spsspssps/spscnc/hw/spscnc/documentation/spscnc_schematic_1.1.0.pdf

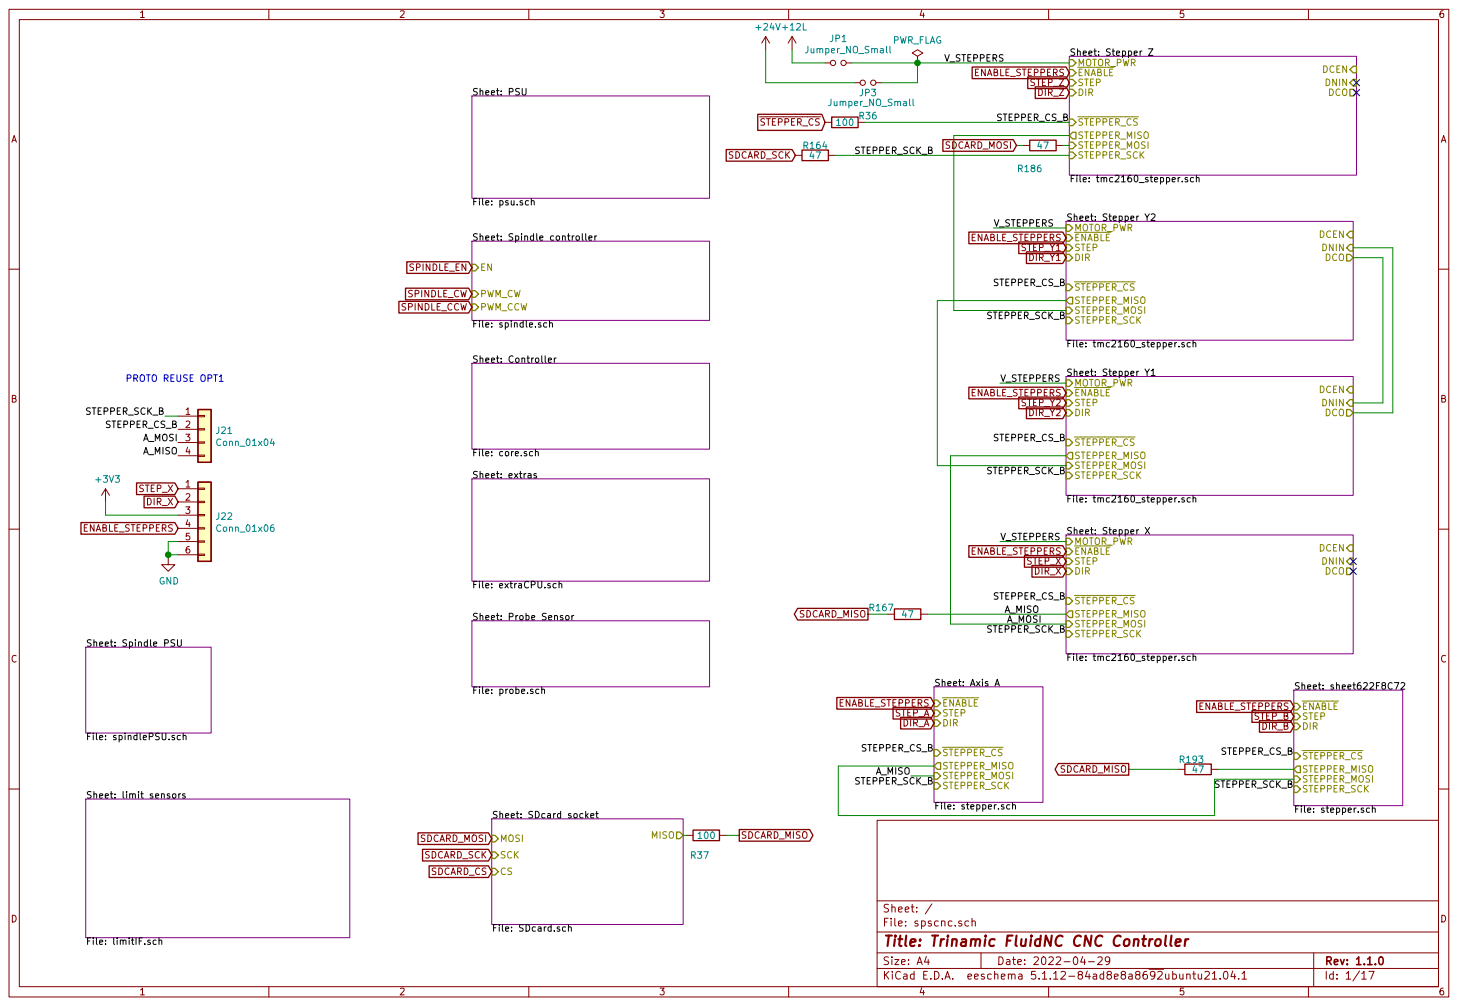
[picture p5: page 1]

Sheet: Probe Sensor File: probe.sch Sheet: extras File: extraCPU.sch Sheet: Spindle controller

File: spindle.sch EN

Sheet: sheet622F8C72 File: stepper.sch STEPPER_CS
ENABLE
STEP DIR

File: spscnc.sch Sheet: /
Id: 1/17 Title: Trinamic FluidNC CNC Controller

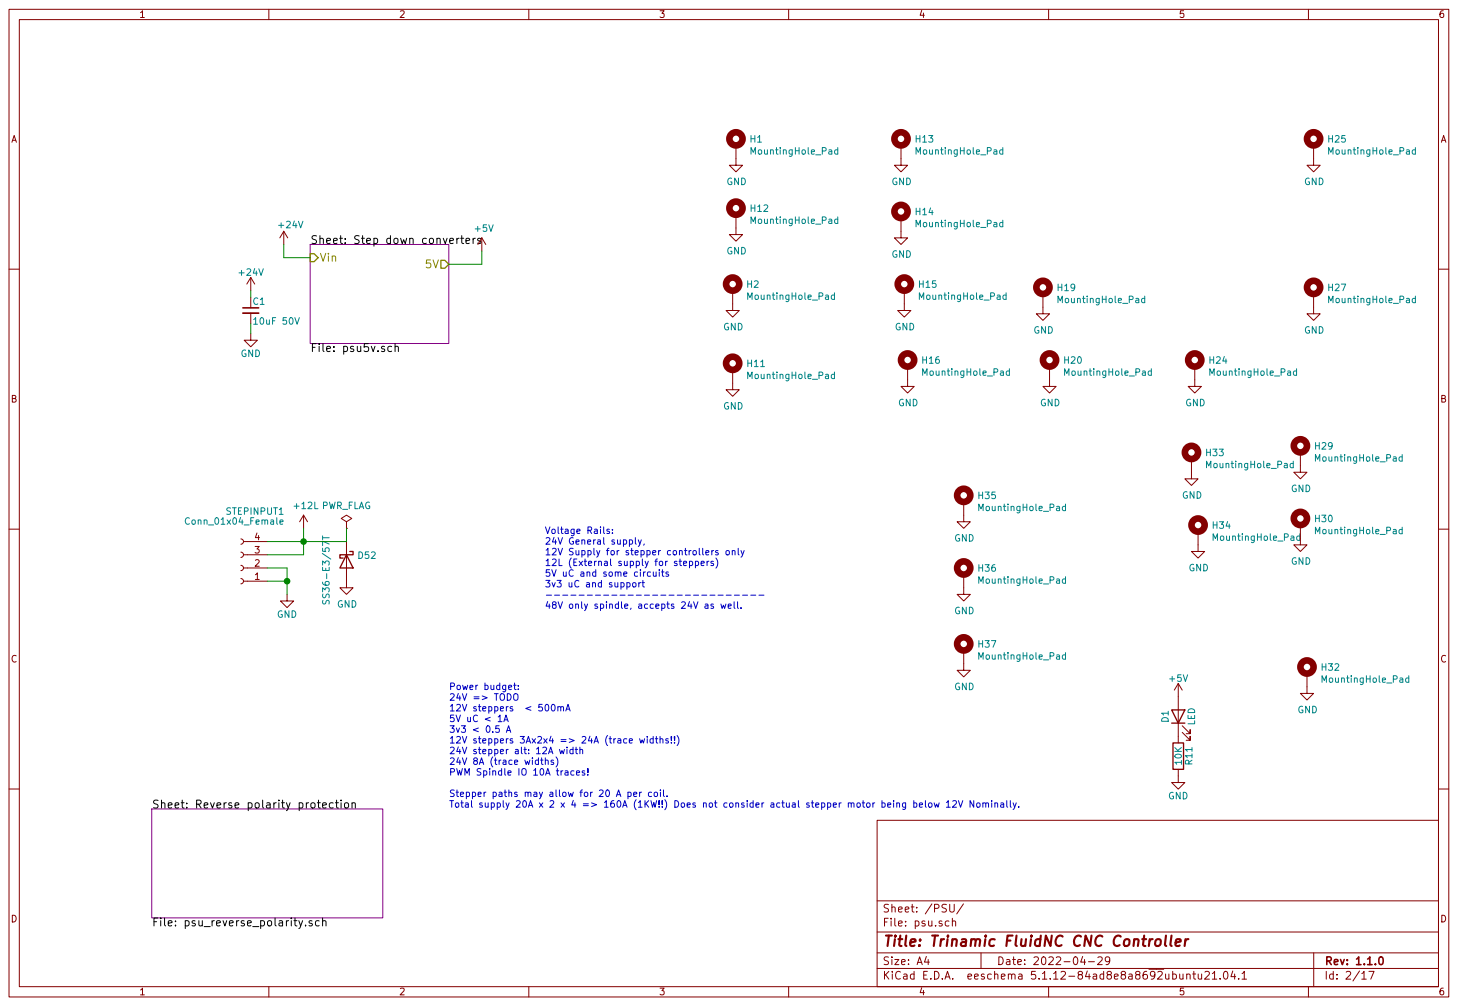
[picture p6: page 2]

Sheet: Step down converters

Voltage Rails:
24V General supply,
12V Supply for stepper controllers only
12L (External supply for steppers) 5V uC and some circuits 3v3 uC and support --------------------------- 48V only spindle, accepts 24V as well.

12V steppers < 500mA
12V steppers 3Ax2x4 => 24A (trace widths!!)
24V stepper alt: 12A width
24V 8A (trace widths)
PWM Spindle IO 10A traces!

Sheet: Reverse polarity protection

Stepper paths may allow for 20 A per coil.
Total supply 20A x 2 x 4 => 160A (1KW!!) Does not consider actual stepper motor being below 12V Nominally.

File: psu.sch Sheet: /PSU/
Id: 2/17 Title: Trinamic FluidNC CNC Controller

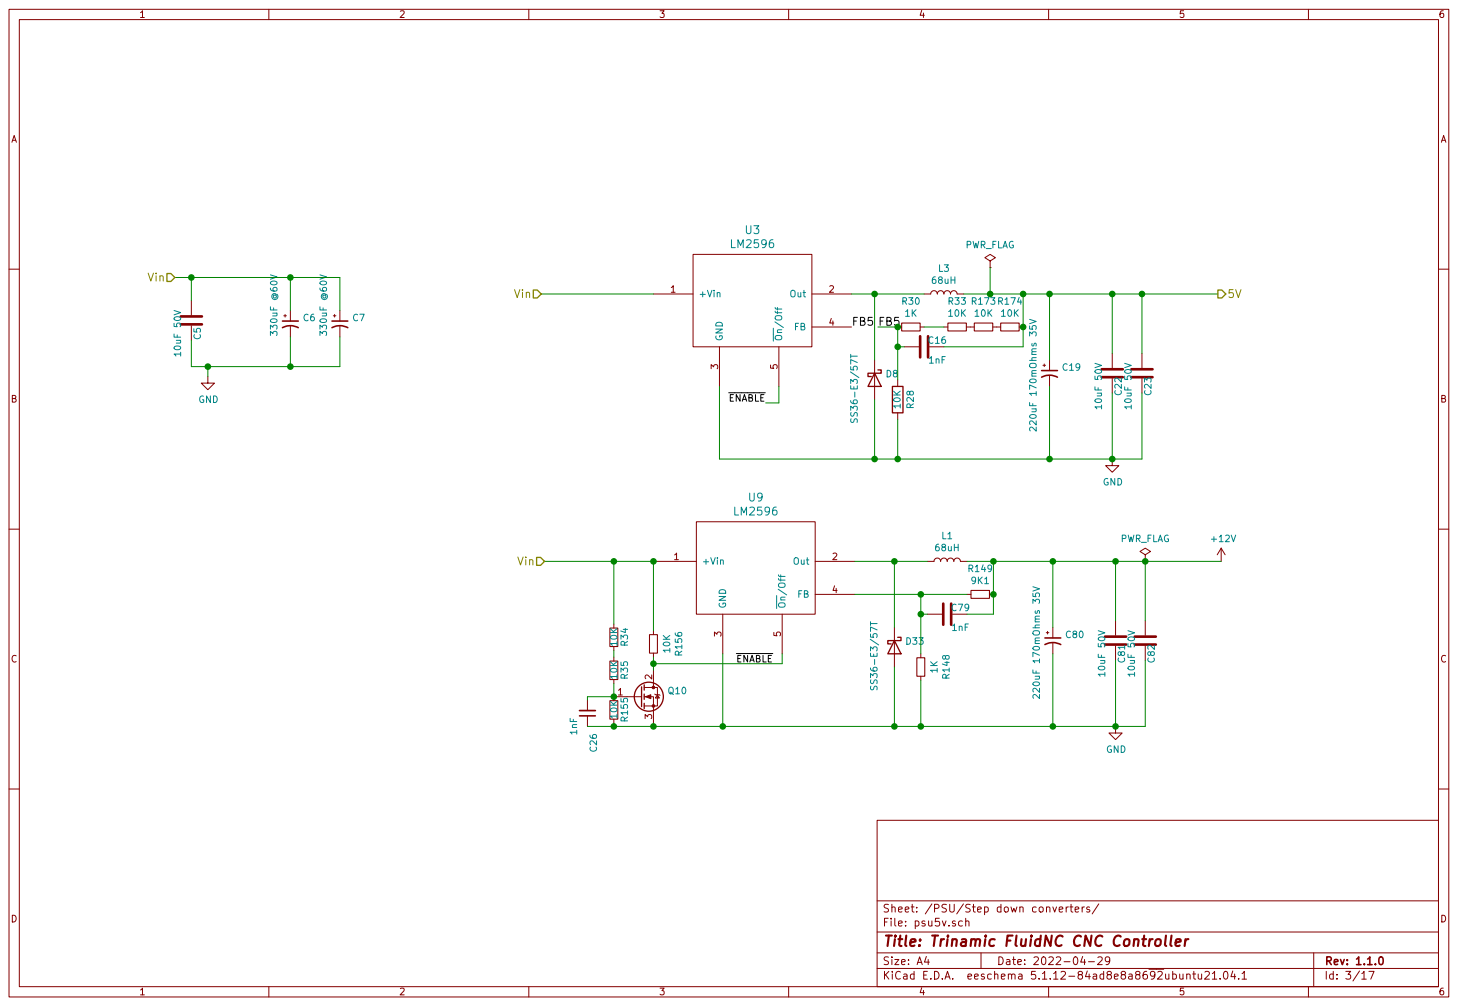
[picture p7: page 3]

File: psu5v.sch
Id: 3/17 Title: Trinamic FluidNC CNC Controller

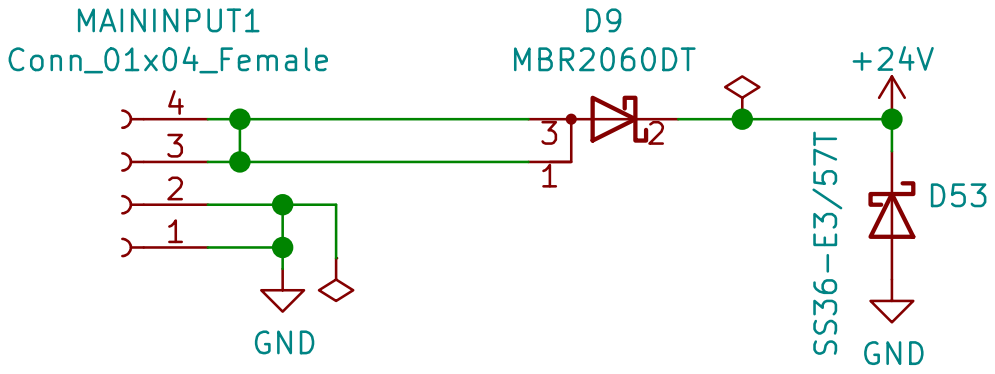
[picture p8: page 4]

File: psu_reverse_polarity.sch
Id: 4/17 Title: Trinamic FluidNC CNC Controller

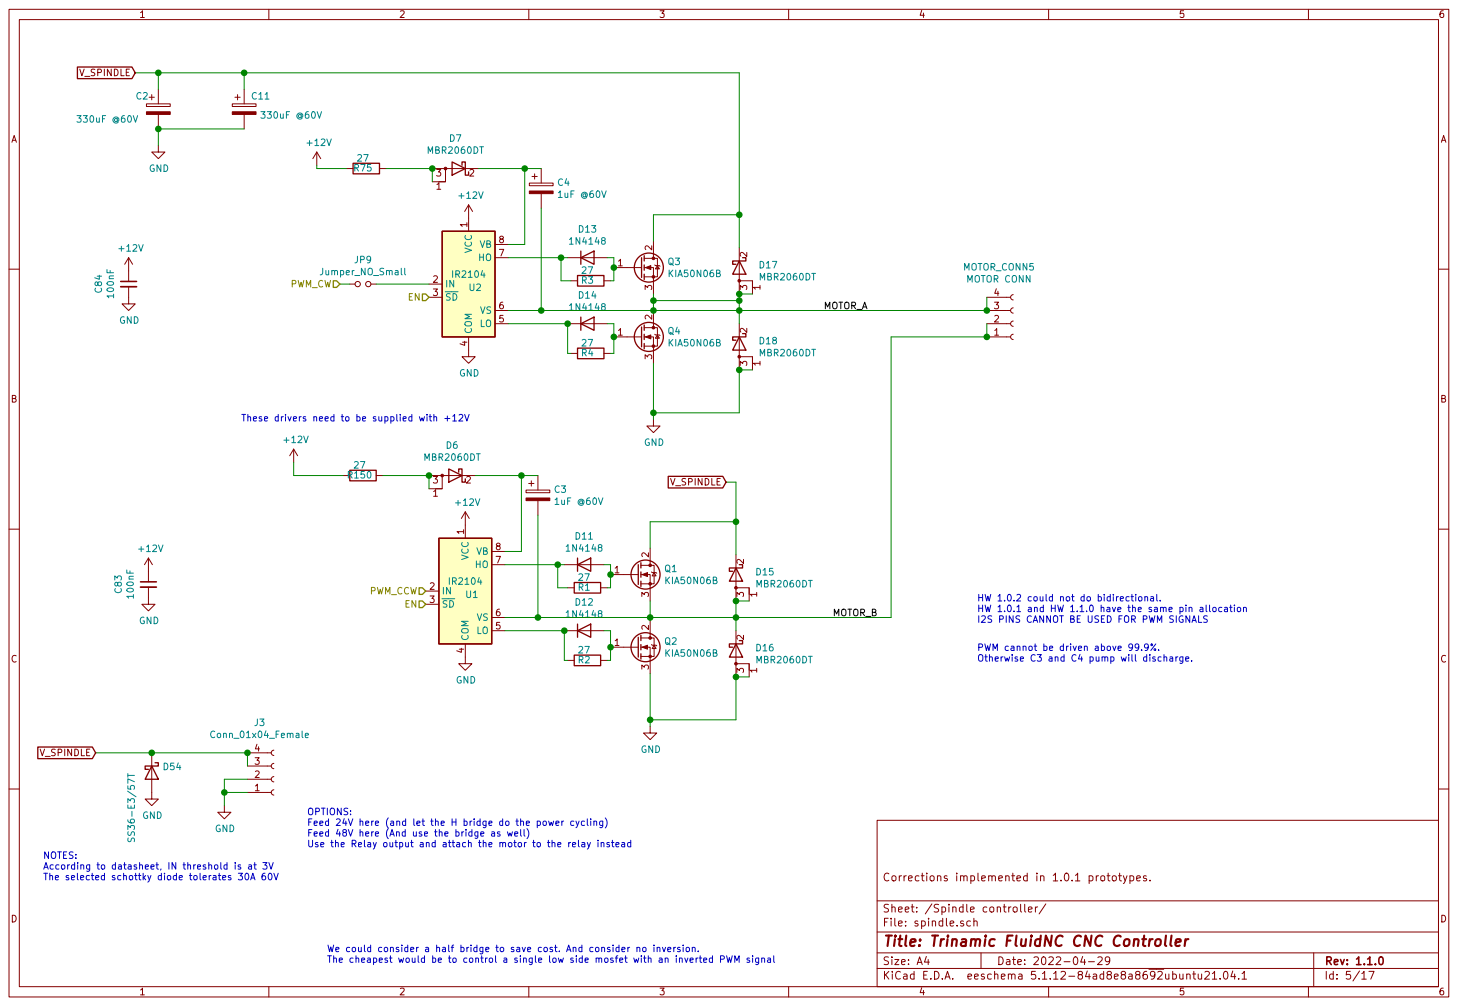
[picture p9: page 5]

These drivers need to be supplied with +12V OPTIONS: Feed 24V here (and let the H bridge do the power cycling)

Corrections implemented in 1.0.1 prototypes. 1

PWM cannot be driven above 99.9%. Otherwise C3 and C4 pump will discharge. HW 1.0.2 could not do bidirectional. HW 1.0.1 and HW 1.1.0 have the same pin allocation

I2S PINS CANNOT BE USED FOR PWM SIGNALS NOTES: According to datasheet, IN threshold is at 3V

Feed 48V here (And use the bridge as well)
Use the Relay output and attach the motor to the relay instead

The selected schottky diode tolerates 30A 60V

Sheet: /Spindle controller/
File: spindle.sch
Id: 5/17 Title: Trinamic FluidNC CNC Controller

We could consider a half bridge to save cost. And consider no inversion.
The cheapest would be to control a single low side mosfet with an inverted PWM signal

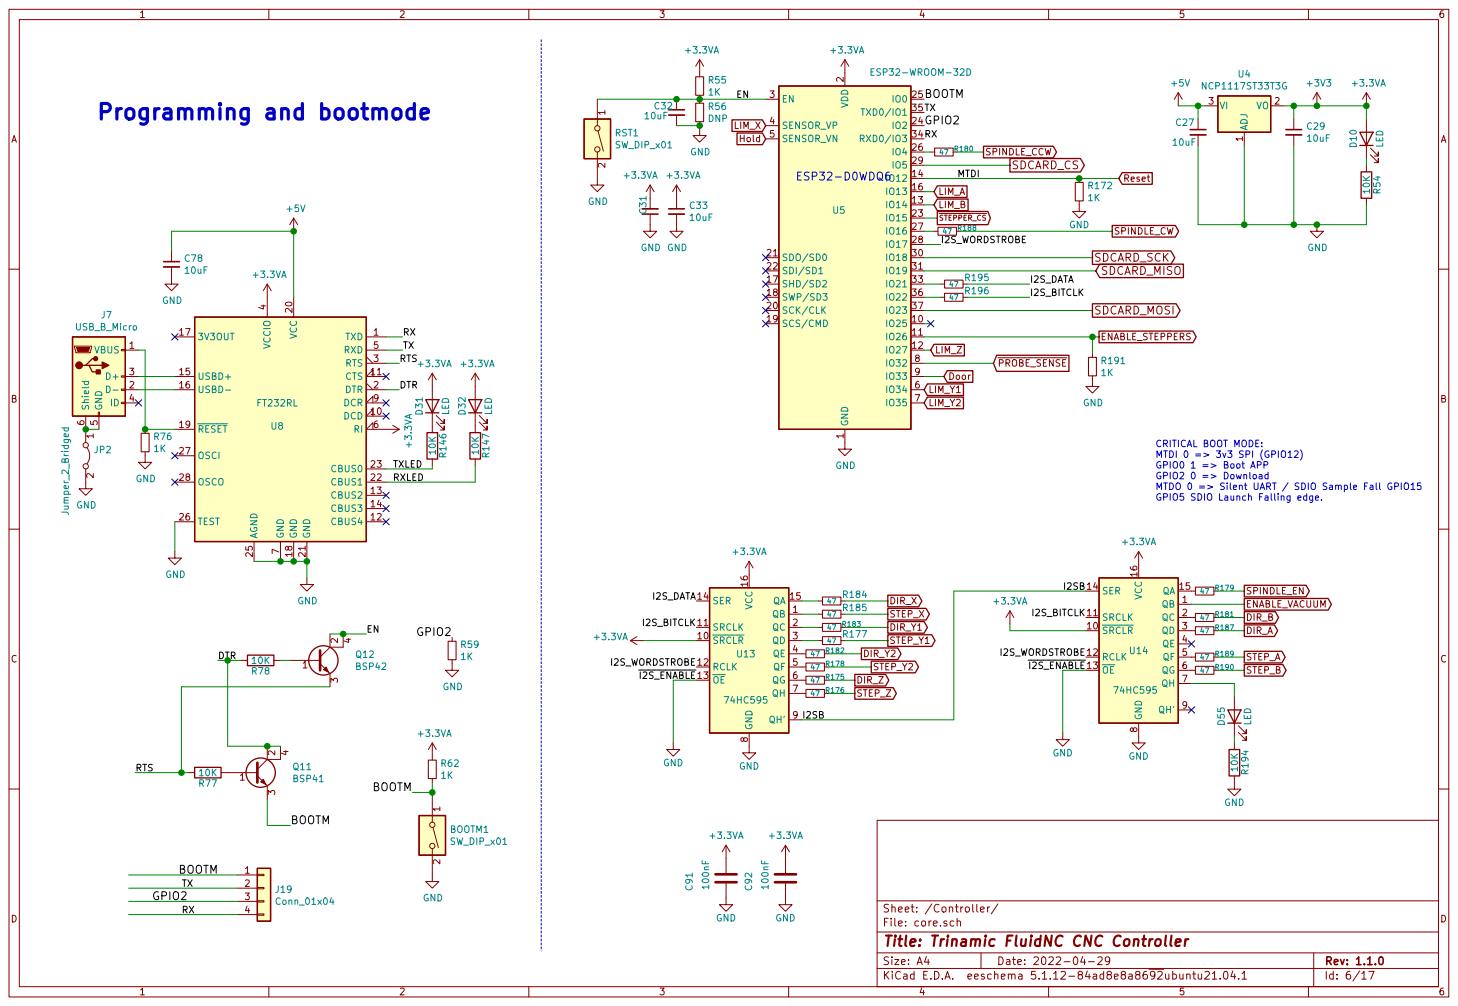
[picture p10: page 6]

2 SCK/CLK 20 SDO/SD0 21 SDI/SD1 22

GPIO5 SDIO Launch Falling edge.

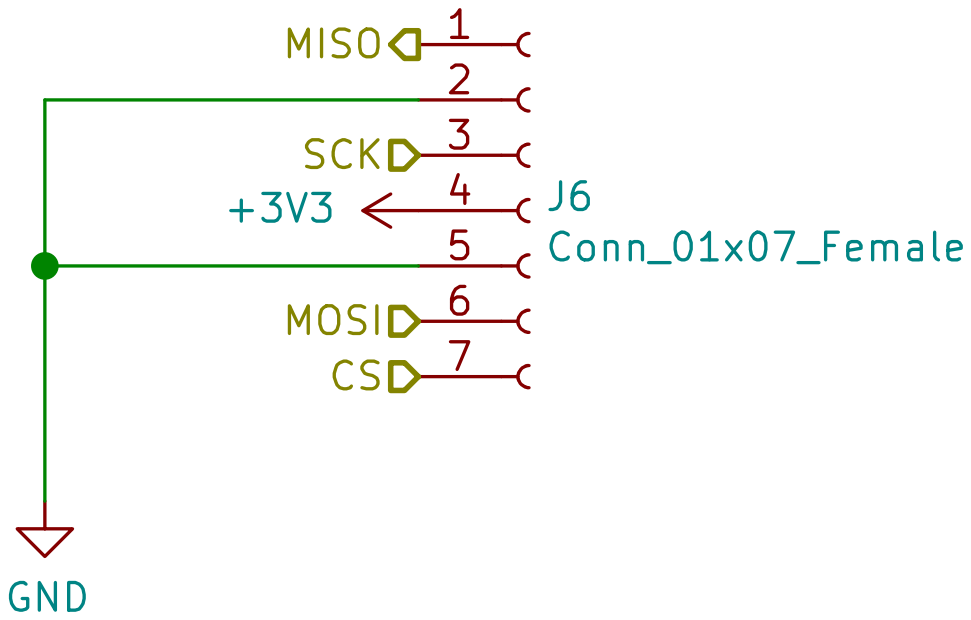
[picture p11: page 7]

Id: 7/17 Title: Trinamic FluidNC CNC Controller File: SDcard.sch Sheet: /SDcard socket/

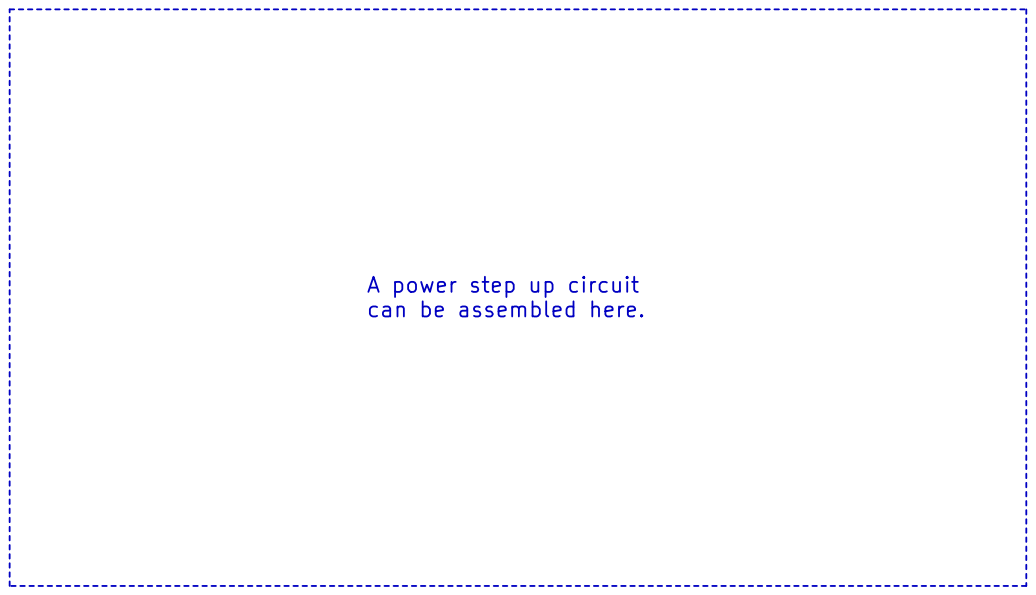
[picture p12: page 8]

A power step up circuit can be assembled here.

Sheet: /Spindle PSU/
File: spindlePSU.sch
Id: 8/17 Title: Trinamic FluidNC CNC Controller

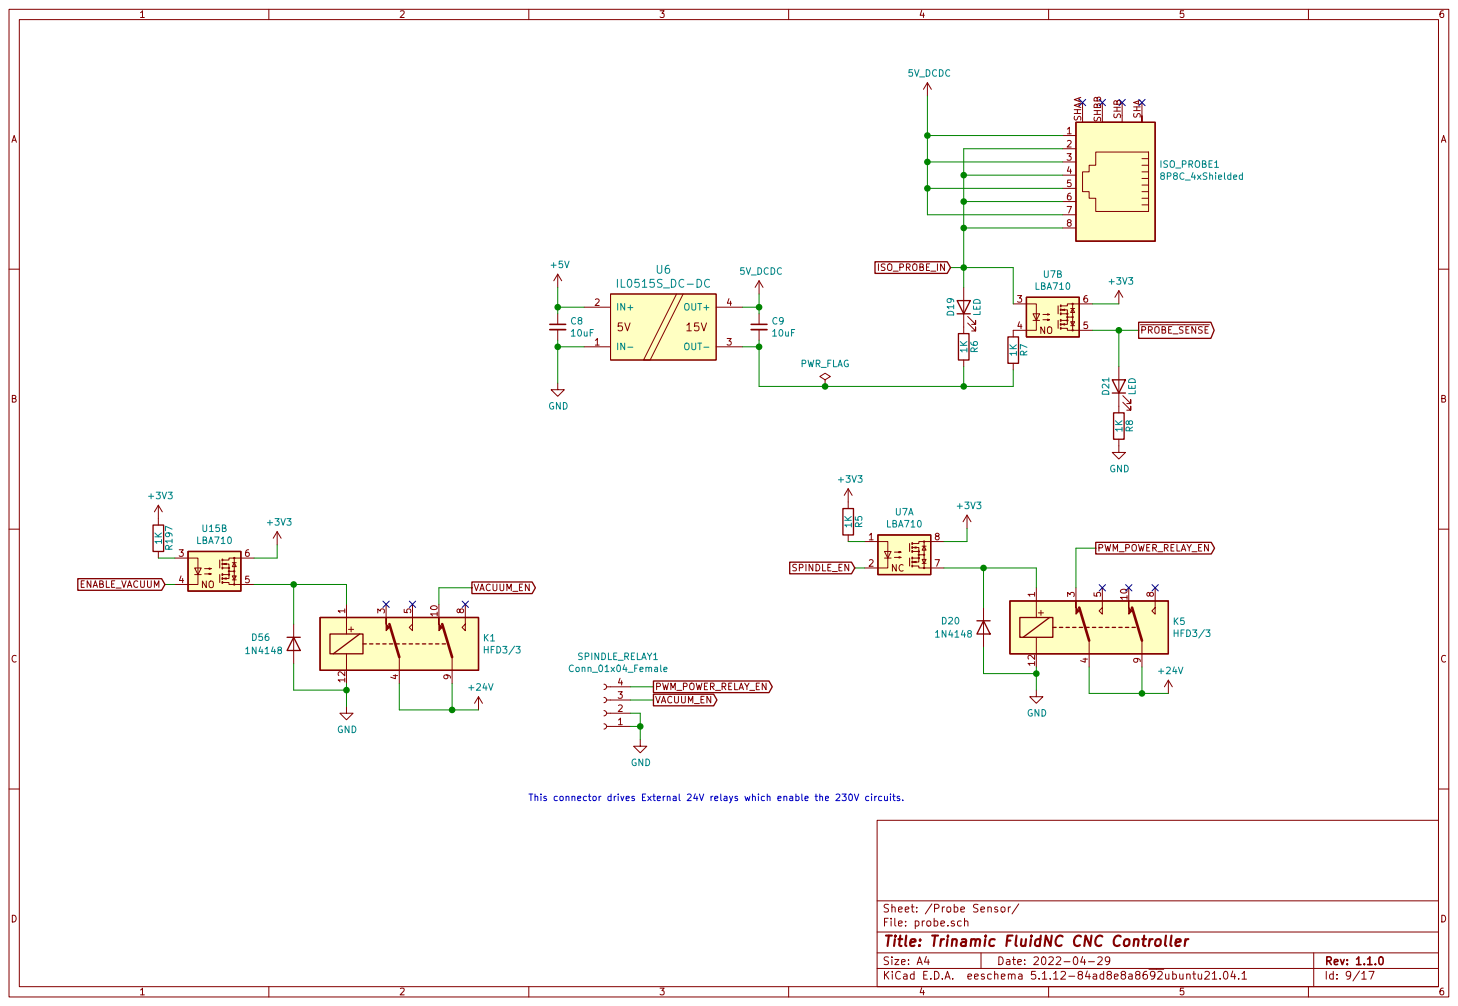
[picture p13: page 9]

This connector drives External 24V relays which enable the 230V circuits.

File: probe.sch Sheet: /Probe Sensor/
Id: 9/17 Title: Trinamic FluidNC CNC Controller

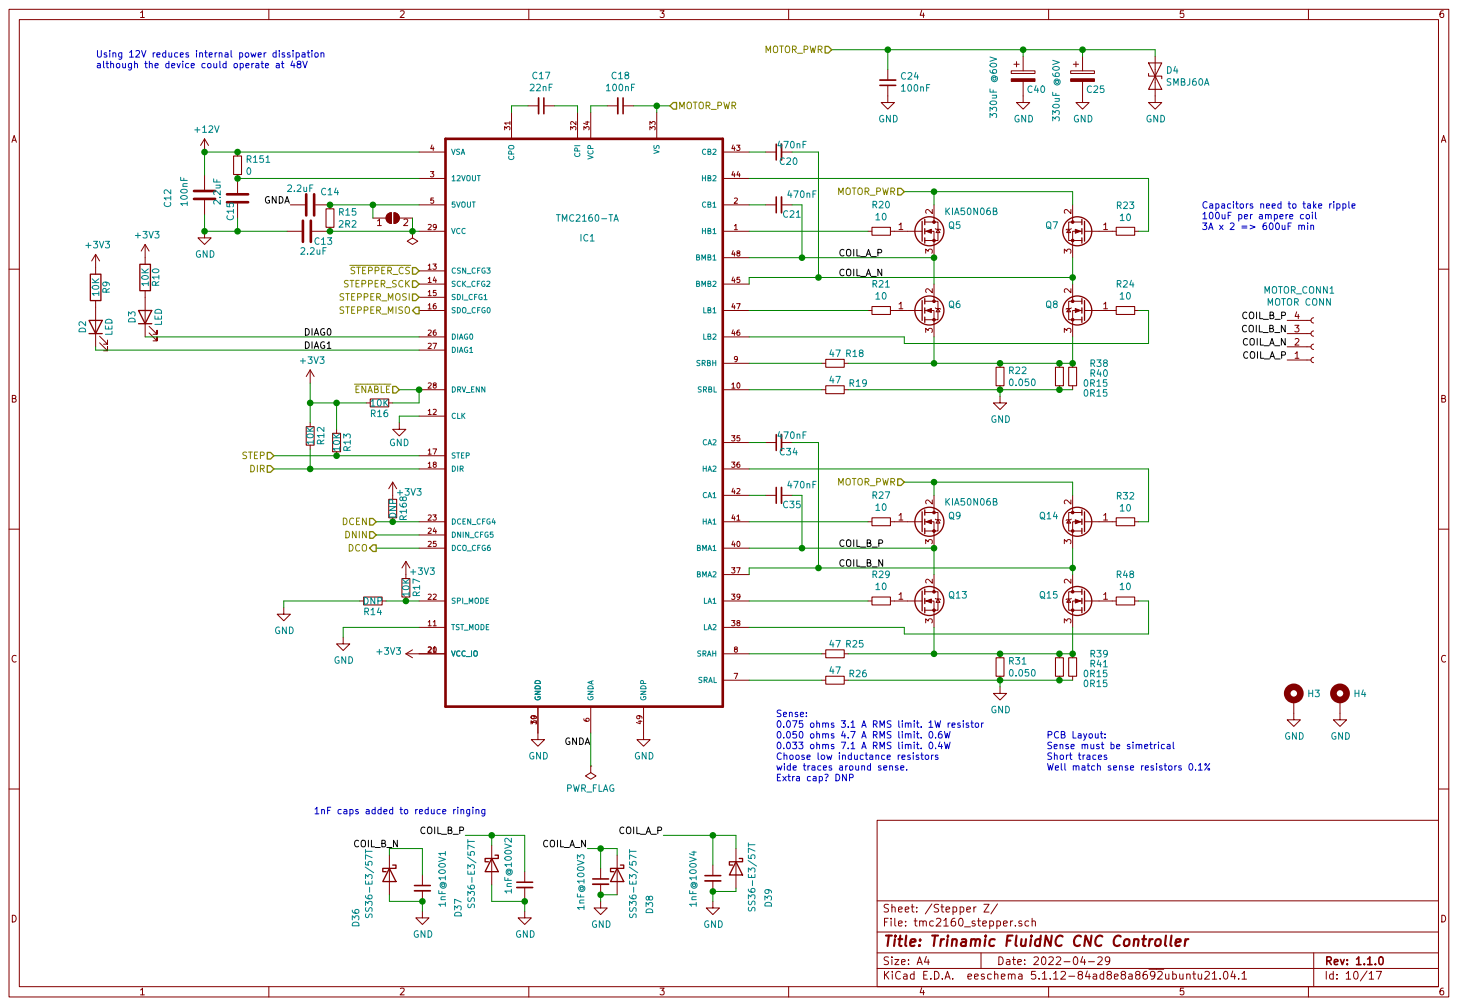
[picture p14: page 10]

Using 12V reduces internal power dissipation
although the device could operate at 48V

6 SRAL 7 SRAH 8 SRBH 9 SRBL 10 TST_MODE 11 CLK 12 CSN_CFG3 13 SCK_CFG2 14 SDI_CFG1 15 SDO_CFG0 16 STEP 17 DIR 18 GNDD 1930 VCC_IO 201 DCO_CFG6 25 SPI_MODE 22 DCEN_CFG4 23 DNIN_CFG5 24 DIAG0 26 DIAG1 27 DRV_ENN 28 VCC 29 CPO 31 CPI 32 VS 33 VCP 34 CA2 35 HA2 36 BMA2 37

Capacitors need to take ripple
100uF per ampere coil 3A x 2 => 600uF min

Sense: 0.075 ohms 3.1 A RMS limit. 1W resistor 0.050 ohms 4.7 A RMS limit. 0.6W

0.033 ohms 7.1 A RMS limit. 0.4W
Choose low inductance resistors wide traces around sense. Extra cap? DNP

1nF caps added to reduce ringing

Sheet: /Stepper Z/
File: tmc2160_stepper.sch
Id: 10/17 Title: Trinamic FluidNC CNC Controller

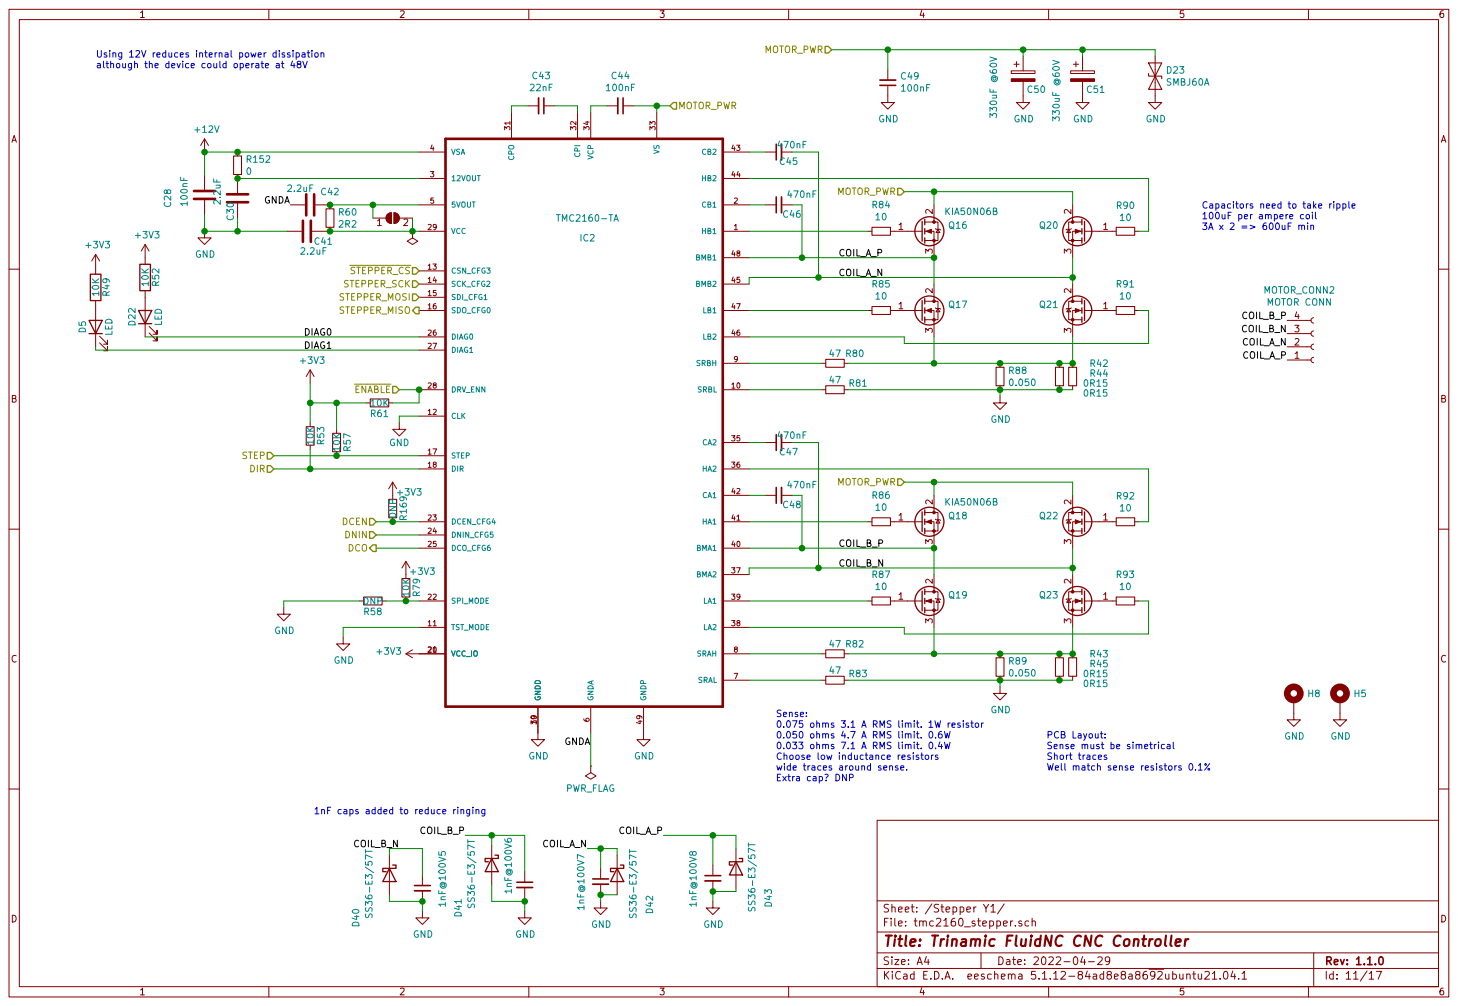
[picture p15: page 11]

Using 12V reduces internal power dissipation
although the device could operate at 48V

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

Capacitors need to take ripple
100uF per ampere coil 3A x 2 => 600uF min

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

1nF caps added to reduce ringing

Sheet: /Stepper Y1/
File: tmc2160_stepper.sch
Id: 11/17 Title: Trinamic FluidNC CNC Controller

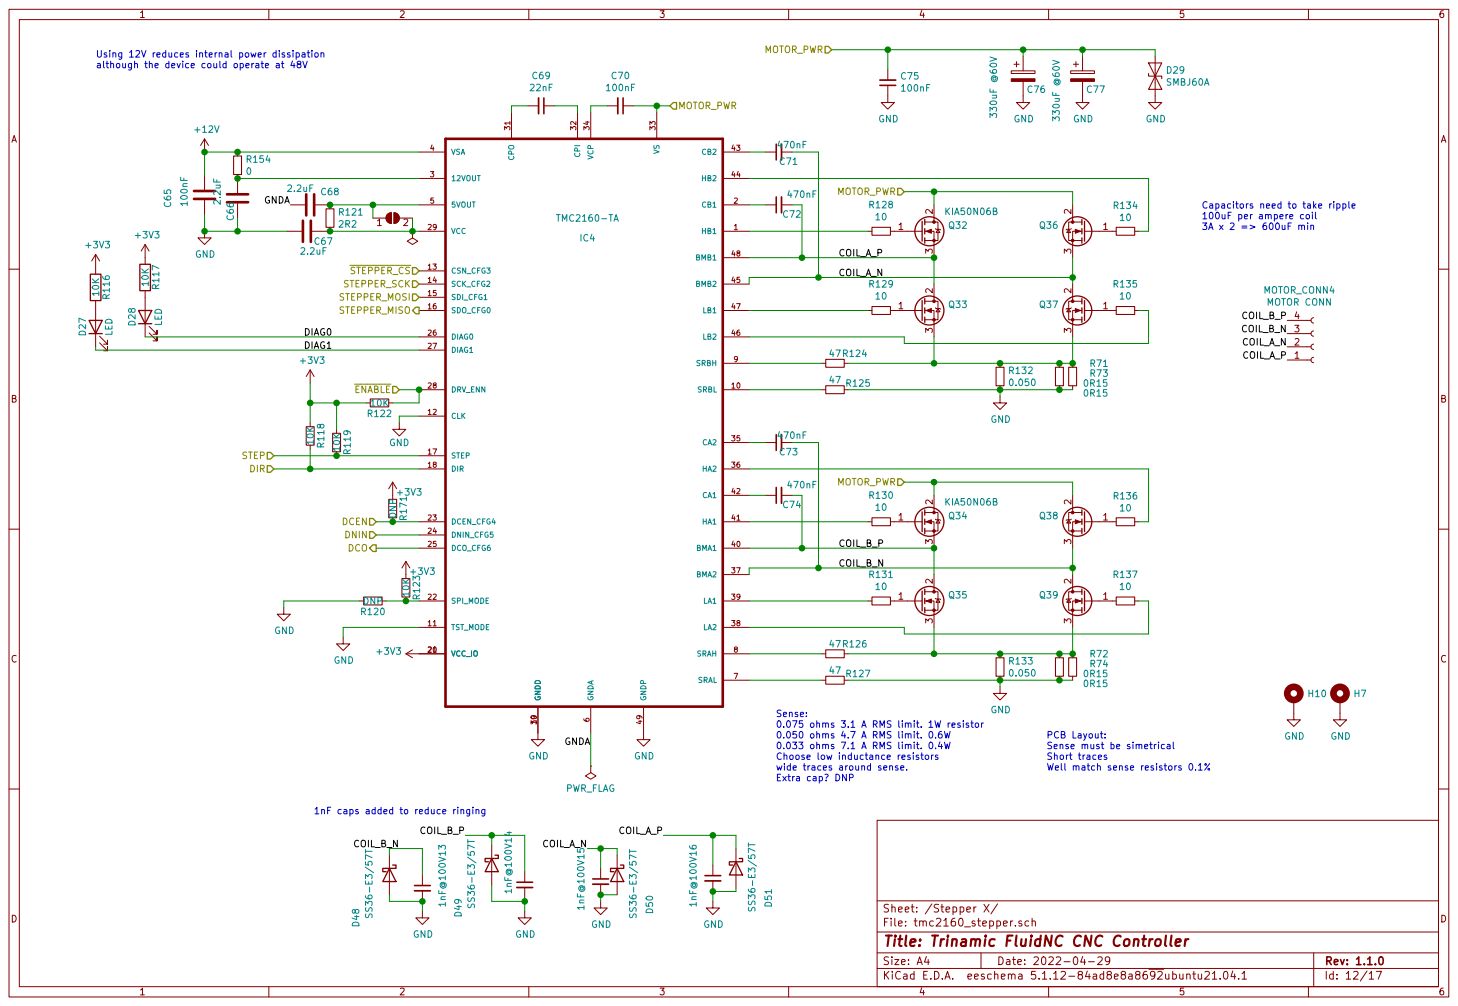
[picture p16: page 12]

Using 12V reduces internal power dissipation
although the device could operate at 48V

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

Capacitors need to take ripple
100uF per ampere coil 3A x 2 => 600uF min

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

1nF caps added to reduce ringing

Sheet: /Stepper X/
File: tmc2160_stepper.sch
Id: 12/17 Title: Trinamic FluidNC CNC Controller

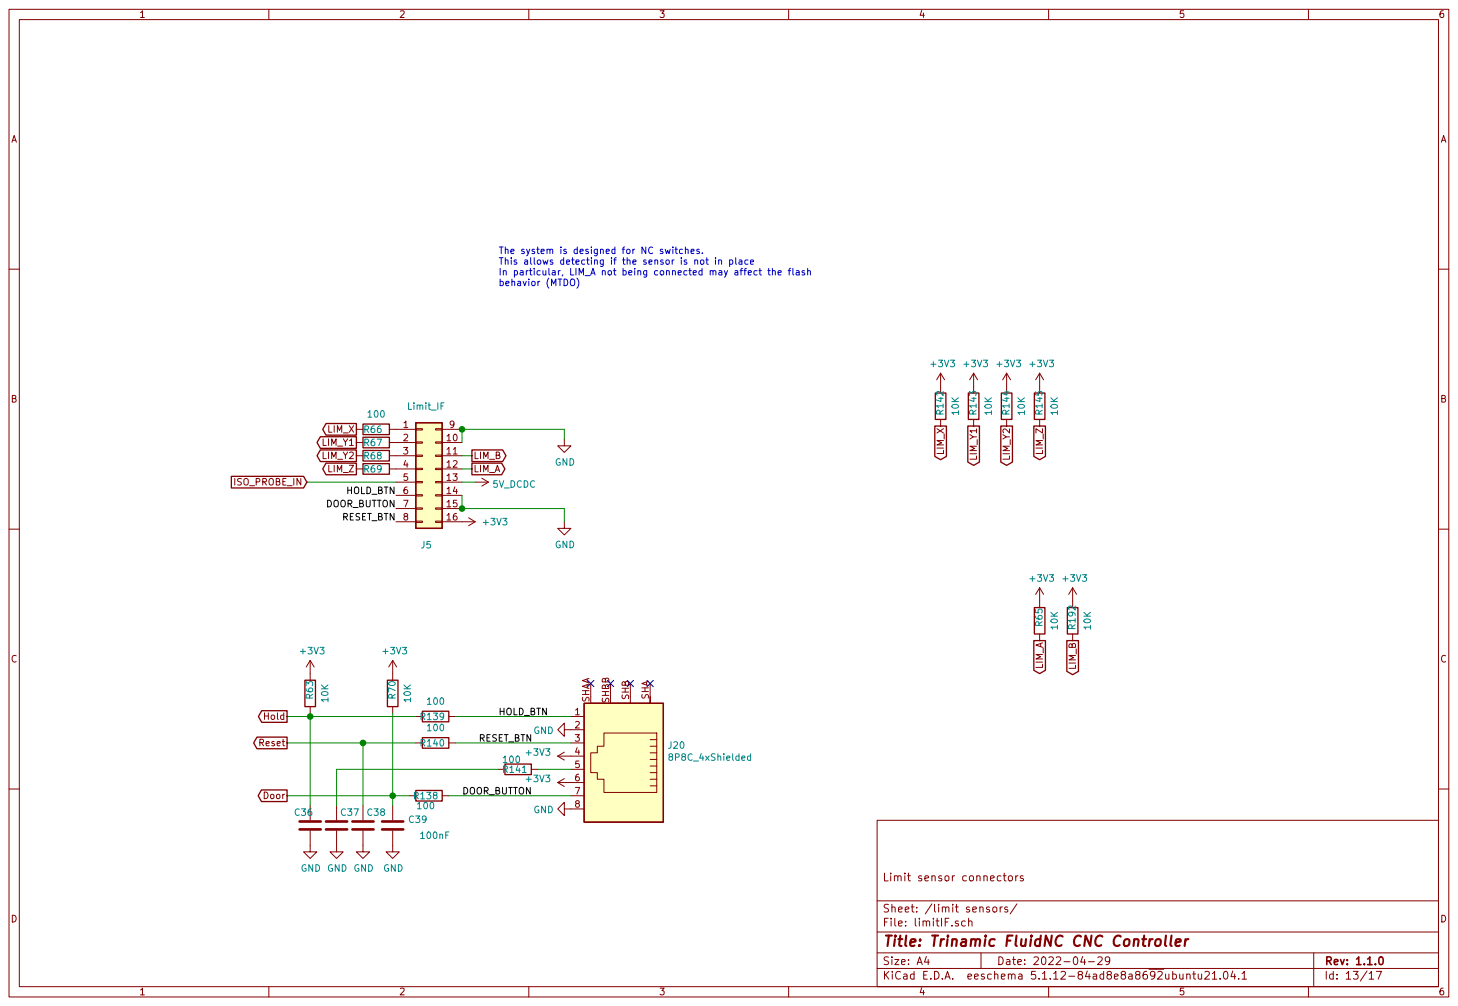
[picture p17: page 13]

The system is designed for NC switches.
This allows detecting if the sensor is not in place
In particular, LIM_A not being connected may affect the flash
behavior (MTDO)
100 C38 GND GND GND GND

Id: 13/17 Title: Trinamic FluidNC CNC Controller File: limitIF.sch Sheet: /limit sensors/ Limit sensor connectors C36

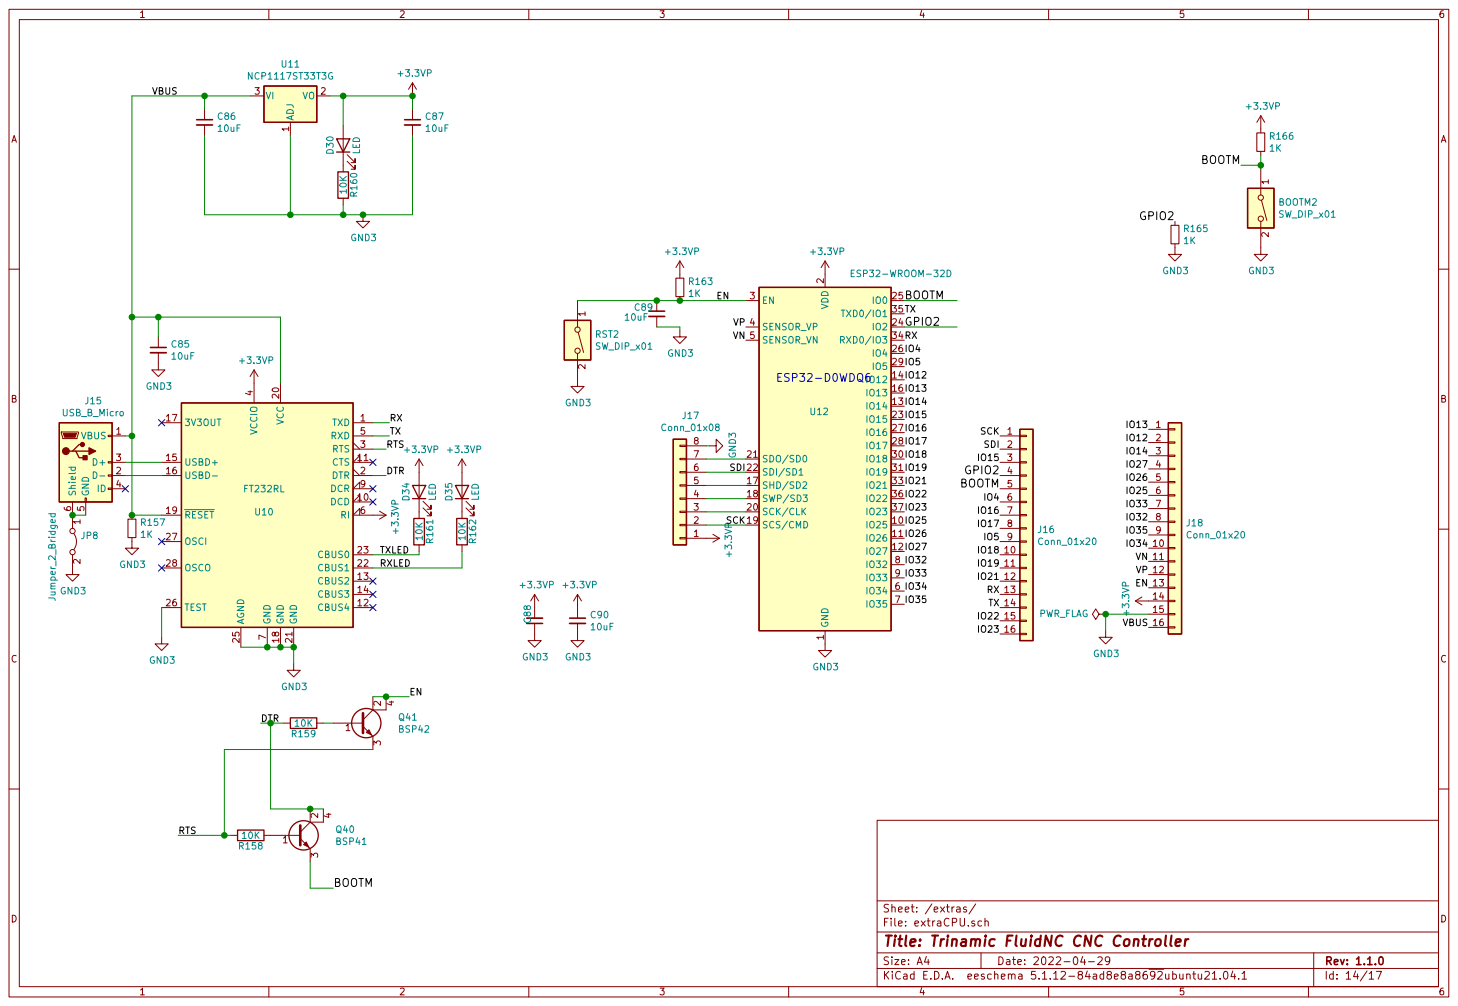
[picture p18: page 14]

2 SCK/CLK 20 SDO/SD0 21 SDI/SD1 22

Id: 14/17 Title: Trinamic FluidNC CNC Controller File: extraCPU.sch Sheet: /extras/

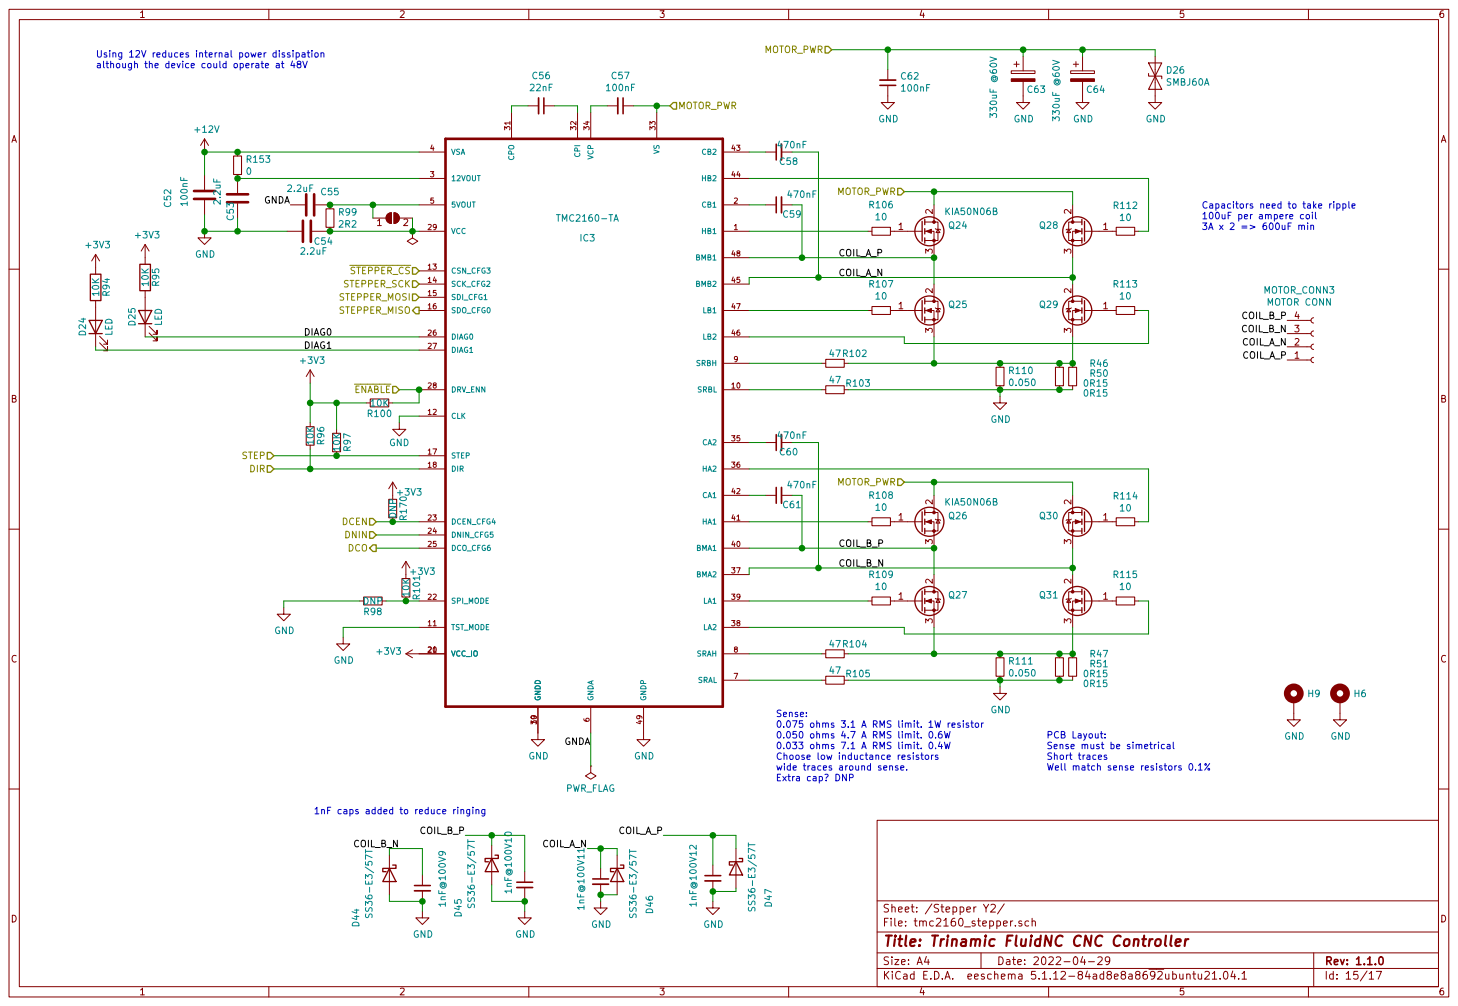
[picture p19: page 15]

Using 12V reduces internal power dissipation
although the device could operate at 48V

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

Capacitors need to take ripple
100uF per ampere coil 3A x 2 => 600uF min

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

1nF caps added to reduce ringing

Sheet: /Stepper Y2/
File: tmc2160_stepper.sch
Id: 15/17 Title: Trinamic FluidNC CNC Controller

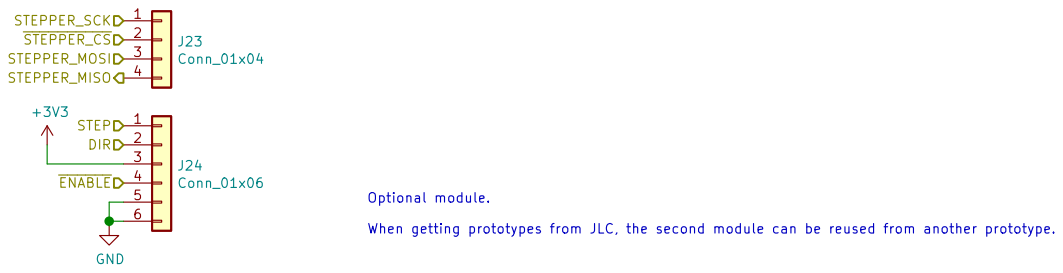
[picture p20: page 16]

When getting prototypes from JLC, the second module can be reused from another prototype.

File: stepper.sch Sheet: /Axis A/
Id: 16/17 Title:

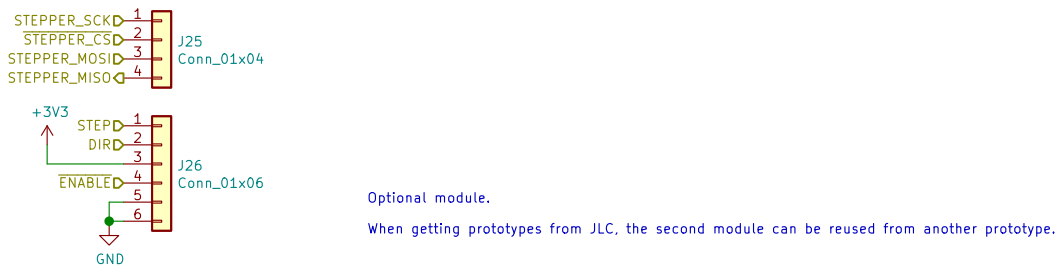
[picture p21: page 17]

When getting prototypes from JLC, the second module can be reused from another prototype.

File: stepper.sch Sheet: /sheet622F8C72/
Id: 17/17 Title:
