spsspssps/spscnc/hw/spscnc/UI.sch

## KiCad design hw/spscnc/UI.sch (2022-02-06)

Schematic: UI.sch

Parts:
C36, C37, C38, C39: 100nF; C_0805_2012Metric_Pad1.18x1.45mm_HandSolder
Inputs1: Conn_01x13_Male; PhoenixContact_MSTBV_2,5_13-GF-5,08_1x13_P5.08mm_Vertical_T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; jlcpcb DNP006
J21: 8P8C_4xShielded; rj45_R-RJ45S08P-B000_C386763; jlcpcb DNP007
R63, R64, R65, R66: 10K; R_0805_2012Metric_Pad1.20x1.40mm_HandSolder; jlcpcb C17414
R67, R68, R69, R70: 100; R_0805_2012Metric_Pad1.20x1.40mm_HandSolder; jlcpcb C17408
