spsspssps/spscnc/hw/spscnc/core.sch

## KiCad design hw/spscnc/core.sch (2022-04-29)

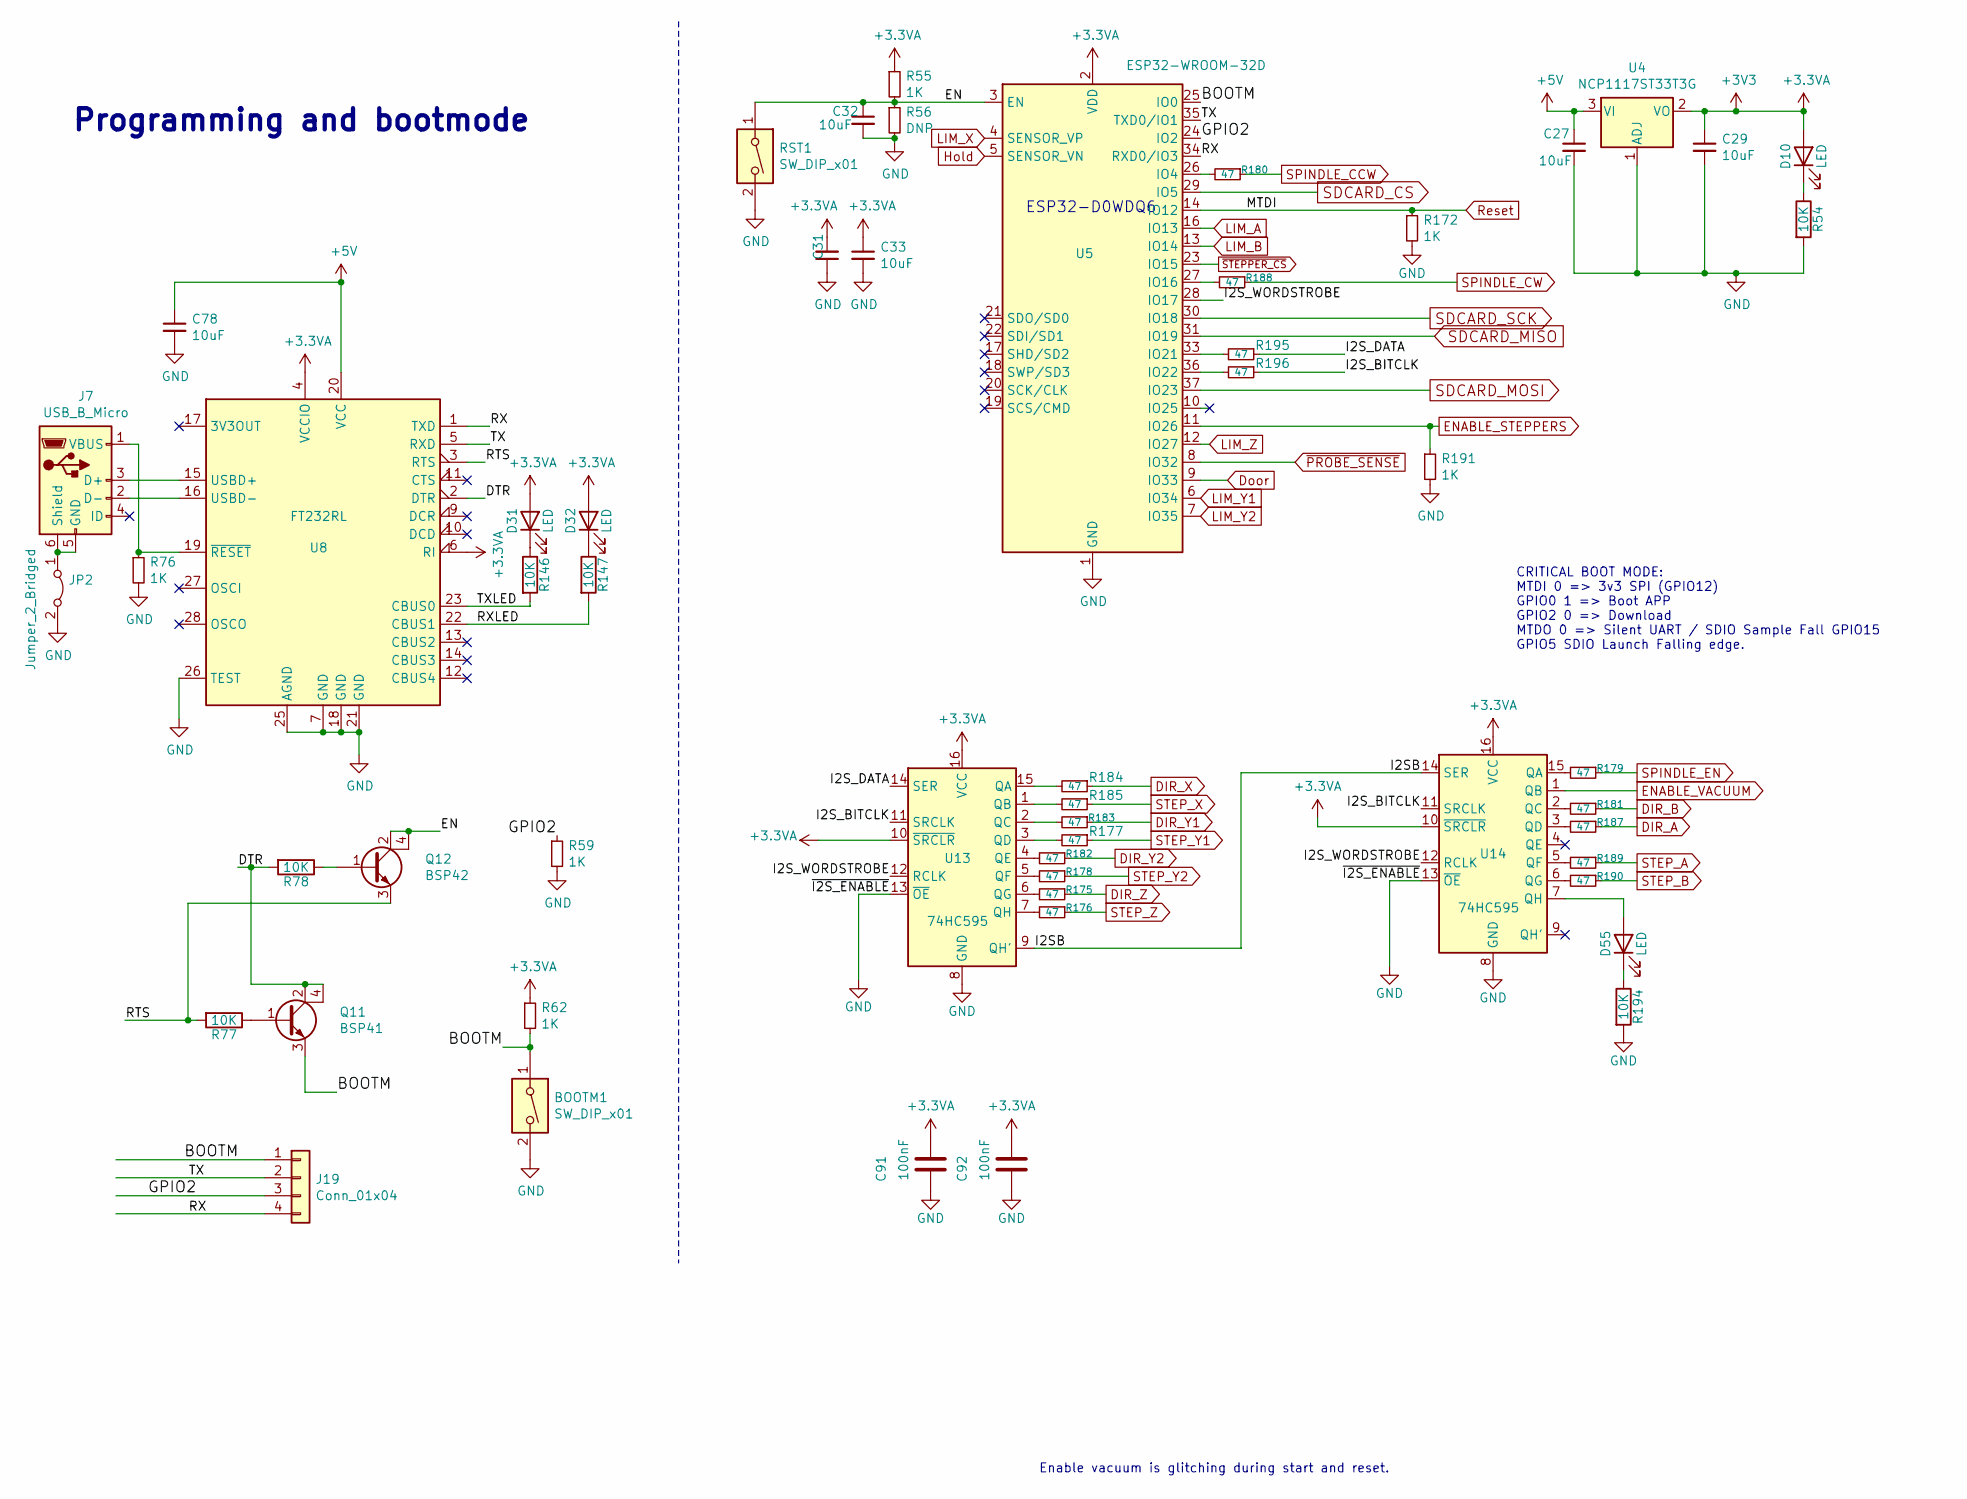
[picture p22: schematic core.sch]

Parts:
BOOTM1: SW_DIP_x01; SW_DIP_SPSTx01_Slide_6.7x4.1mm_W6.73mm_P2.54mm_LowProfile_J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; jlcpcb DNP001
C8, C91, C92: 100nF; C_0603_1608Metric; jlcpcb C14663
C9, C38, C78, C111, C130: 10uF; C_1206_3216Metric; jlcpcb C13585
D1, D31, D32, D55: LED; D_0805_2012Metric; jlcpcb C84256
J7: USB_B_Micro; USB_Micro-B_Molex-105017-0001; jlcpcb HOMESTOCK010
J11: Conn_01x04; PinHeader_1x04_P2.54mm_Vertical; jlcpcb DNP008
JP2: Jumper_2_Bridged; SolderJumper-2_P1.3mm_Bridged2Bar_Pad1.0x1.5mm; jlcpcb DNP024
Q11: BSP41; SOT-223; jlcpcb HOMESTOCK003
Q12: BSP42; SOT-223; jlcpcb HOMESTOCK003
R8, R77, R78, R146, R147, R194: 10K; R_0805_2012Metric; jlcpcb C17414
R23, R41, R44, R76, R172, R191: 1K; R_0603_1608Metric; jlcpcb C21190
R26: DNP; R_0402_1005Metric; jlcpcb DNP002
R175, R176, R177, R178, R179, R180, R181, R182, R183, R184, R185, R187, R188, R189, R190, R195, R196: 47; R_0805_2012Metric; jlcpcb C17714
RST1: SW_DIP_x01; SW_DIP_SPSTx01_Slide_6.7x4.1mm_W6.73mm_P2.54mm_LowProfile_J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; jlcpcb DNP011
U3: NCP1117ST33T3G; SOT-223-3_TabPin2; jlcpcb HOMEAMS1117-3v3
U4: ESP32-WROOM-32D; ESP32-WROOM-32; jlcpcb STOCKSELF
U8: FT232RL; SSOP-28_5.3x10.2mm_P0.65mm; jlcpcb HOMESTOCK01
U13, U14: 74HC595; SOIC-16_3.9x9.9mm_P1.27mm; jlcpcb C5947

Connections:
+3.3VA: C8.2, C9.1, C91.2, C92.2, C130.1, D1.2 (A), D31.2 (A), D32.2 (A), R23.1, R44.1, U3.2 (VO), U4.2 (VDD), U8.4 (VCCIO), U8.6 (RI), U13.10 (~SRCLR), U13.16 (VCC), U14.10 (~SRCLR), U14.16 (VCC)
+5V: C78.1, C111.1, U3.3 (VI), U8.20 (VCC)
BOOTM: BOOTM1.1, J11.1, Q11.3 (E), R44.2, U4.25 (IO0)
DIR_A: R187.1
DIR_B: R181.1
DIR_X: R184.1
DIR_Y1: R183.1
DIR_Y2: R182.1
DIR_Z: R175.1
DTR: Q11.2 (C), Q11.4 (C), R78.2, U8.2 (DTR)
Door: U4.9 (IO33)
EN: C38.1, Q12.2 (C), Q12.4 (C), R23.2, R26.1, RST1.1, U4.3 (EN)
ENABLE_STEPPERS: R191.1, U4.11 (IO26)
ENABLE_VACUUM: U14.1 (QB)
GND: BOOTM1.2, C8.1, C9.2, C38.2, C78.2, C91.1, C92.1, C111.2, C130.2, JP2.2 (B), R8.2, R26.2, R41.2, R76.2, R172.2, R191.2, R194.2, RST1.2, U3.1 (ADJ), U4.1 (GND), U4.15 (GND), U4.38 (GND), U4.39 (GND), U8.7 (GND), U8.18 (GND), U8.21 (GND), U8.25 (AGND), U8.26 (TEST), U13.8 (GND), U13.13 (~OE), U14.8 (GND), U14.13 (~OE)
GPIO2: J11.3, R41.1, U4.24 (IO2)
Hold: U4.5 (SENSOR_VN)
I2SB: U13.9 (QH'), U14.14 (SER)
I2S_BITCLK: R196.1, U13.11 (SRCLK), U14.11 (SRCLK)
I2S_DATA: R195.1, U13.14 (SER)
I2S_WORDSTROBE: U4.28 (IO17), U13.12 (RCLK), U14.12 (RCLK)
LIM_A: U4.16 (IO13)
LIM_B: U4.13 (IO14)
LIM_X: U4.4 (SENSOR_VP)
LIM_Y1: U4.6 (IO34)
LIM_Y2: U4.7 (IO35)
LIM_Z: U4.12 (IO27)
unnamed: D1.1 (K), R8.1
unnamed: D31.1 (K), R146.1
unnamed: D32.1 (K), R147.1
unnamed: D55.1 (K), R194.1
unnamed: D55.2 (A), U14.7 (QH)
unnamed: J7.1 (VBUS), R76.1, U8.19 (~RESET~)
unnamed: J7.2 (D-), U8.16 (USBD-)
unnamed: J7.3 (D+), U8.15 (USBD+)
unnamed: J7.5 (GND), J7.6 (Shield), JP2.1 (A)
unnamed: Q11.1 (B), R77.1
unnamed: Q12.1 (B), R78.1
unnamed: R175.2, U13.6 (QG)
unnamed: R176.2, U13.7 (QH)
unnamed: R177.2, U13.3 (QD)
unnamed: R178.2, U13.5 (QF)
unnamed: R179.2, U14.15 (QA)
unnamed: R180.2, U4.26 (IO4)
unnamed: R181.2, U14.2 (QC)
unnamed: R182.2, U13.4 (QE)
unnamed: R183.2, U13.2 (QC)
unnamed: R184.2, U13.15 (QA)
unnamed: R185.2, U13.1 (QB)
unnamed: R187.2, U14.3 (QD)
unnamed: R188.2, U4.27 (IO16)
unnamed: R189.2, U14.5 (QF)
unnamed: R190.2, U14.6 (QG)
unnamed: R195.2, U4.33 (IO21)
unnamed: R196.2, U4.36 (IO22)
RTS: Q12.3 (E), R77.2, U8.3 (RTS)
RX: J11.4, U4.34 (RXD0/IO3), U8.1 (TXD)
RXLED: R147.2, U8.22 (CBUS1)
Reset: R172.1, U4.14 (IO12)
SDCARD_CS: U4.29 (IO5)
SDCARD_MISO: U4.31 (IO19)
SDCARD_MOSI: U4.37 (IO23)
SDCARD_SCK: U4.30 (IO18)
SPINDLE_CCW: R180.1
SPINDLE_CW: R188.1
SPINDLE_EN: R179.1
STEP_A: R189.1
STEP_B: R190.1
STEP_X: R185.1
STEP_Y1: R177.1
STEP_Y2: R178.1
STEP_Z: R176.1
TX: J11.2, U4.35 (TXD0/IO1), U8.5 (RXD)
TXLED: R146.2, U8.23 (CBUS0)
~PROBE_SENSE: U4.8 (IO32)
~STEPPER_CS: U4.23 (IO15)

Notes on the sheet:
ESP32-D0WDQ6
Programming and bootmode
CRITICAL BOOT MODE: MTDI 0 => 3v3 SPI (GPIO12) GPIO0 1 => Boot APP GPIO2 0 => Download MTDO 0 => Silent UART / SDIO Sample Fall GPIO15 GPIO5 SDIO Launch Falling edge.
Enable vacuum is glitching during start and reset.
