spsspssps/spscnc/hw/spscnc/espcore.sch

## KiCad design hw/spscnc/espcore.sch (2022-02-06)

Schematic: espcore.sch

Parts:
BOOTM1: SW_DIP_x01; SW_DIP_SPSTx01_Slide_6.7x4.1mm_W6.73mm_P2.54mm_LowProfile_J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; jlcpcb DNP001
C8: 100nF; C_0603_1608Metric; jlcpcb C14663
C9, C38, C78, C111, C130: 10uF; C_1206_3216Metric; jlcpcb C13585
D1, D31, D32: LED; D_0805_2012Metric; jlcpcb C84256
J7: USB_B_Micro; USB_Micro-B_Molex-105017-0001; jlcpcb HOMESTOCK010
J11: Conn_01x04; PinHeader_1x04_P2.54mm_Vertical; jlcpcb DNP101
JP2: Jumper_2_Bridged; SolderJumper-2_P1.3mm_Bridged2Bar_Pad1.0x1.5mm; jlcpcb DNP950
Q11: BSP41; SOT-223; jlcpcb HOMESTOCK003
Q12: BSP42; SOT-223; jlcpcb HOMESTOCK003
R8, R77, R78, R146, R147: 10K; R_0805_2012Metric; jlcpcb C17414
R23, R41, R44, R76, R172: 1K; R_0603_1608Metric; jlcpcb C21190
R26: DNP; R_0402_1005Metric; jlcpcb DNP002
RST1: SW_DIP_x01; SW_DIP_SPSTx01_Slide_6.7x4.1mm_W6.73mm_P2.54mm_LowProfile_J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; jlcpcb DNP200
U3: NCP1117ST33T3G; SOT-223-3_TabPin2; jlcpcb HOMEAMS1117-3v3
U4: ESP32-WROOM-32D; ESP32-WROOM-32; jlcpcb C529578
U8: FT232RL; SSOP-28_5.3x10.2mm_P0.65mm; jlcpcb HOMESTOCK01

Notes on the sheet:
ESP32-D0WDQ6
DRV8825 design used io15 for the door
Programming and bootmode
