spsspssps/spscnc/hw/spscnc/extraCPU.sch

## KiCad design hw/spscnc/extraCPU.sch (2022-04-29)

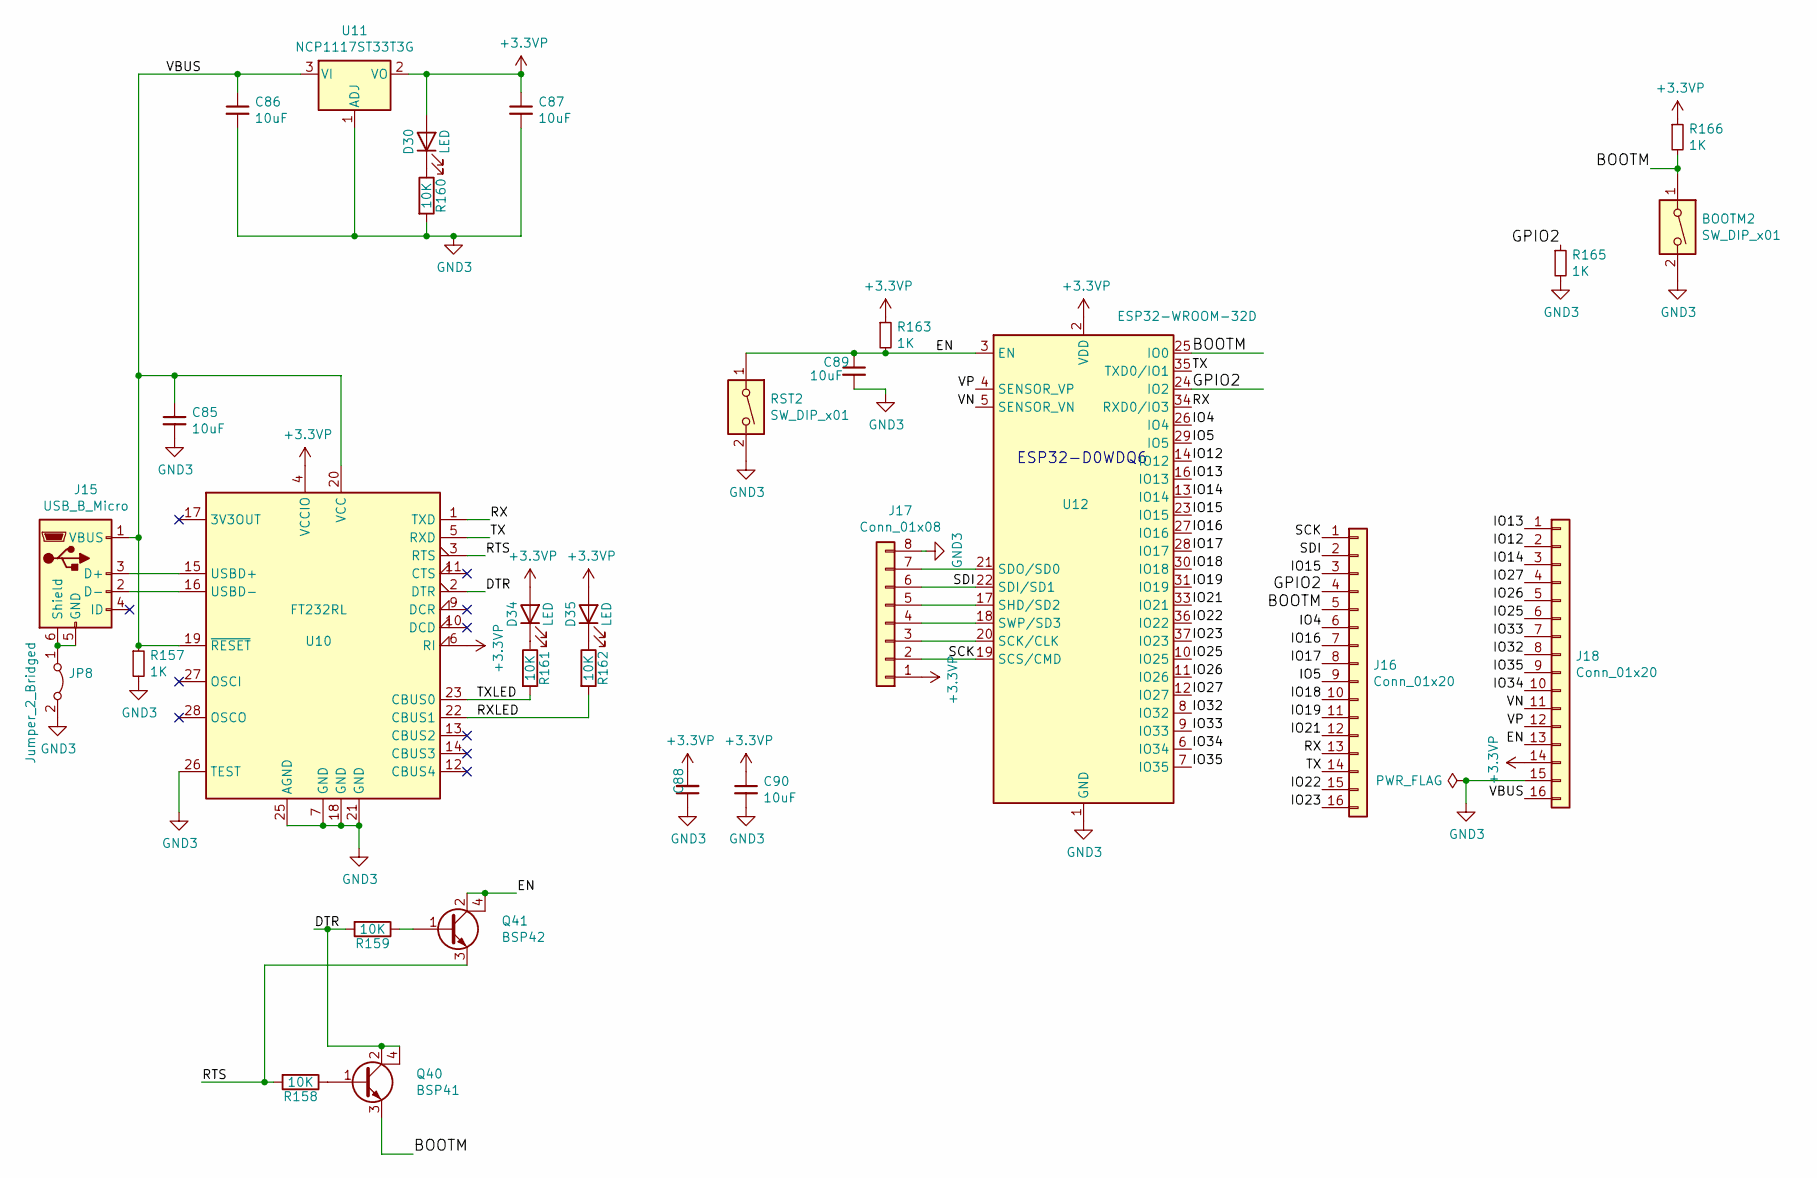
[picture p23: schematic extraCPU.sch]

Parts:
BOOTM2: SW_DIP_x01; SW_DIP_SPSTx01_Slide_6.7x4.1mm_W6.73mm_P2.54mm_LowProfile_J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; jlcpcb DNP001
C85, C86, C87, C89, C90: 10uF; C_1206_3216Metric; jlcpcb C13585
C88: 100nF; C_0603_1608Metric; jlcpcb C14663
D30, D34, D35: LED; D_0805_2012Metric; jlcpcb C84256
J15: USB_B_Micro; USB_Micro-B_Molex-105017-0001; jlcpcb HOMESTOCK010
J16, J18: Conn_01x20; PinHeader_1x16_P2.54mm_Vertical; jlcpcb DNP022
J17: Conn_01x08; PinHeader_1x08_P2.54mm_Vertical; jlcpcb DNP021
JP8: Jumper_2_Bridged; SolderJumper-2_P1.3mm_Bridged2Bar_Pad1.0x1.5mm; jlcpcb DNP024
Q40: BSP41; SOT-223; jlcpcb HOMESTOCK003
Q41: BSP42; SOT-223; jlcpcb HOMESTOCK003
R157, R163, R165, R166: 1K; R_0603_1608Metric; jlcpcb C21190
R158, R159, R160, R161, R162: 10K; R_0805_2012Metric; jlcpcb C17414
RST2: SW_DIP_x01; SW_DIP_SPSTx01_Slide_6.7x4.1mm_W6.73mm_P2.54mm_LowProfile_J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; jlcpcb DNP011
U10: FT232RL; SSOP-28_5.3x10.2mm_P0.65mm; jlcpcb HOMESTOCK01
U11: NCP1117ST33T3G; SOT-223-3_TabPin2; jlcpcb HOMEAMS1117-3v3
U12: ESP32-WROOM-32D; ESP32-WROOM-32; jlcpcb STOCKSELF

Connections:
+3.3VP: C87.1, C88.2, C90.1, D30.2 (A), D34.2 (A), D35.2 (A), J17.1, J18.14, R163.1, R166.1, U10.4 (VCCIO), U10.6 (RI), U11.2 (VO), U12.2 (VDD)
BOOTM: BOOTM2.1, J16.5, Q40.3 (E), R166.2, U12.25 (IO0)
DTR: Q40.2 (C), Q40.4 (C), R159.2, U10.2 (DTR)
EN: C89.1, J18.13, Q41.2 (C), Q41.4 (C), R163.2, RST2.1, U12.3 (EN)
GND3: BOOTM2.2, C85.2, C86.2, C87.2, C88.1, C89.2, C90.2, J17.8, J18.15, JP8.2 (B), R157.2, R160.2, R165.2, RST2.2, U10.7 (GND), U10.18 (GND), U10.21 (GND), U10.25 (AGND), U10.26 (TEST), U11.1 (ADJ), U12.1 (GND), U12.15 (GND), U12.38 (GND), U12.39 (GND)
GPIO2: J16.4, R165.1, U12.24 (IO2)
IO4: J16.6, U12.26 (IO4)
IO5: J16.9, U12.29 (IO5)
IO12: J18.2, U12.14 (IO12)
IO13: J18.1, U12.16 (IO13)
IO14: J18.3, U12.13 (IO14)
IO15: J16.3, U12.23 (IO15)
IO16: J16.7, U12.27 (IO16)
IO17: J16.8, U12.28 (IO17)
IO18: J16.10, U12.30 (IO18)
IO19: J16.11, U12.31 (IO19)
IO21: J16.12, U12.33 (IO21)
IO22: J16.15, U12.36 (IO22)
IO23: J16.16, U12.37 (IO23)
IO25: J18.6, U12.10 (IO25)
IO26: J18.5, U12.11 (IO26)
IO27: J18.4, U12.12 (IO27)
IO32: J18.8, U12.8 (IO32)
IO33: J18.7, U12.9 (IO33)
IO34: J18.10, U12.6 (IO34)
IO35: J18.9, U12.7 (IO35)
unnamed: D30.1 (K), R160.1
unnamed: D34.1 (K), R161.1
unnamed: D35.1 (K), R162.1
unnamed: J15.2 (D-), U10.16 (USBD-)
unnamed: J15.3 (D+), U10.15 (USBD+)
unnamed: J15.5 (GND), J15.6 (Shield), JP8.1 (A)
unnamed: J17.3, U12.20 (SCK/CLK)
unnamed: J17.4, U12.18 (SWP/SD3)
unnamed: J17.5, U12.17 (SHD/SD2)
unnamed: J17.7, U12.21 (SDO/SD0)
unnamed: Q40.1 (B), R158.1
unnamed: Q41.1 (B), R159.1
RTS: Q41.3 (E), R158.2, U10.3 (RTS)
RX: J16.13, U10.1 (TXD), U12.34 (RXD0/IO3)
RXLED: R162.2, U10.22 (CBUS1)
SCK: J16.1, J17.2, U12.19 (SCS/CMD)
SDI: J16.2, J17.6, U12.22 (SDI/SD1)
TX: J16.14, U10.5 (RXD), U12.35 (TXD0/IO1)
TXLED: R161.2, U10.23 (CBUS0)
VBUS: C85.1, C86.1, J15.1 (VBUS), J18.16, R157.1, U10.19 (~RESET~), U10.20 (VCC), U11.3 (VI)
VN: J18.11, U12.5 (SENSOR_VN)
VP: J18.12, U12.4 (SENSOR_VP)

Notes on the sheet:
ESP32-D0WDQ6
