spsspssps/spscnc/hw/spscnc/limitIF.sch

## KiCad design hw/spscnc/limitIF.sch (2022-04-29)

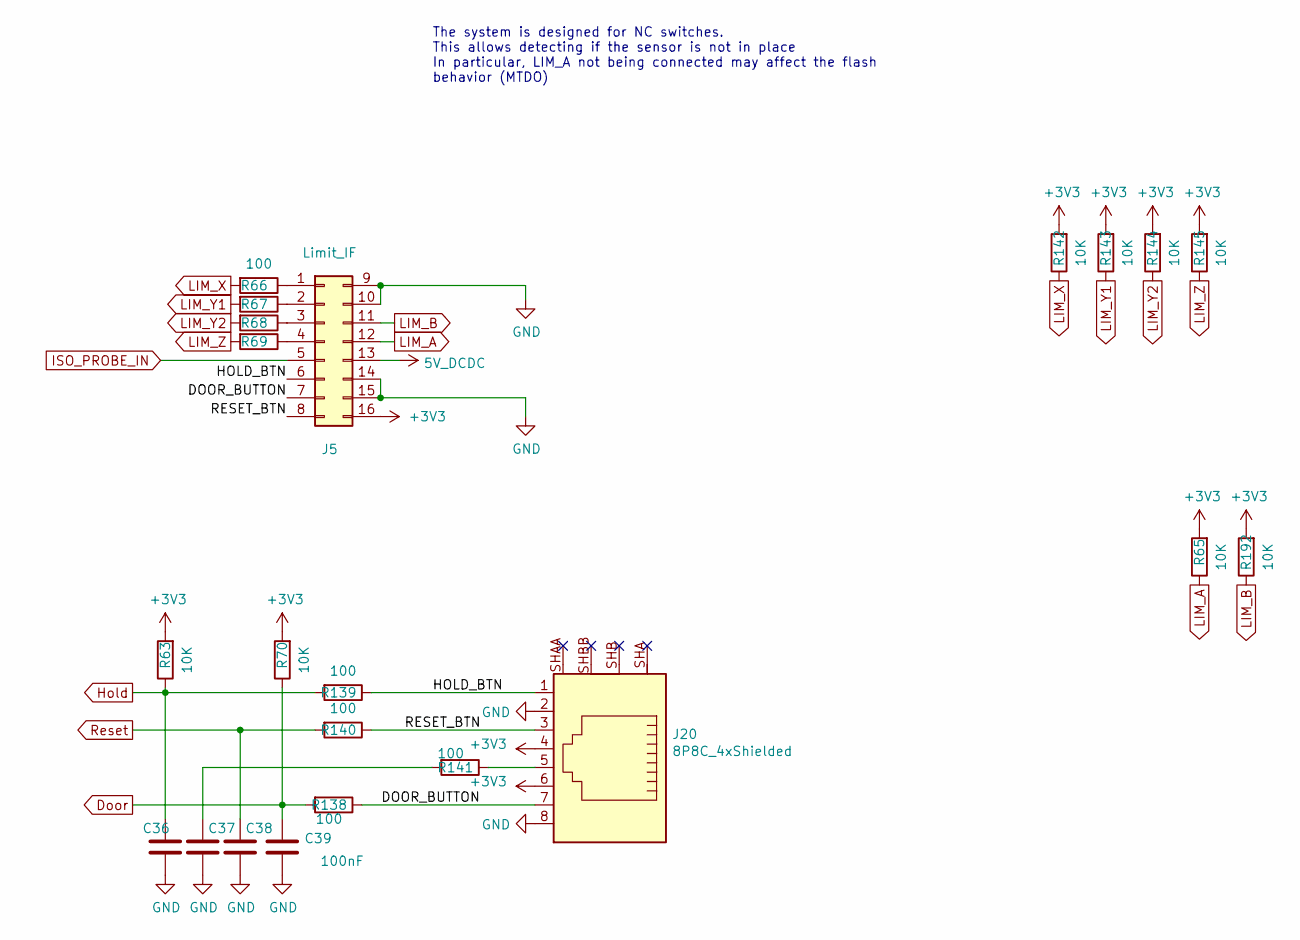
[picture p24: schematic limitIF.sch]

Parts:
C36, C37, C38, C39: 100nF; C_0603_1608Metric; jlcpcb C14663
J5: Limit_IF; connRPC2x8_3.5mm2.5mm; jlcpcb DNP020
J20: 8P8C_4xShielded; rj45_R-RJ45S08P-B000_C386763; jlcpcb DNP007
R63, R65, R70, R142, R143, R144, R145, R192: 10K; R_0805_2012Metric; jlcpcb C17414
R66, R67, R68, R69, R138, R139, R140, R141: 100; R_0805_2012Metric; jlcpcb C17408

Connections:
5V_DCDC: J5.13
+3V3: J5.16, J20.4, J20.6, R63.2, R65.2, R70.2, R142.2, R143.2, R144.2, R145.2, R192.2
DOOR_BUTTON: J5.7, J20.7, R138.1
Door: C39.1, R70.1, R138.2
GND: C36.2, C37.2, C38.2, C39.2, J5.9, J5.10, J5.14, J5.15, J20.2, J20.8
HOLD_BTN: J5.6, J20.1, R139.1
Hold: C36.1, R63.1, R139.2
ISO_PROBE_IN: J5.5
LIM_A: J5.12, R65.1
LIM_B: J5.11, R192.1
LIM_X: R66.2, R142.1
LIM_Y1: R67.2, R143.1
LIM_Y2: R68.2, R144.1
LIM_Z: R69.2, R145.1
unnamed: C37.1, R141.2
unnamed: J5.1, R66.1
unnamed: J5.2, R67.1
unnamed: J5.3, R68.1
unnamed: J5.4, R69.1
unnamed: J20.5, R141.1
RESET_BTN: J5.8, J20.3, R140.1
Reset: C38.1, R140.2

Notes on the sheet:
The system is designed for NC switches. This allows detecting if the sensor is not in place In particular, LIM_A not being connected may affect the flash behavior (MTDO)
