spsspssps/spscnc/hw/spscnc/probe.sch

## KiCad design hw/spscnc/probe.sch (2022-04-29)

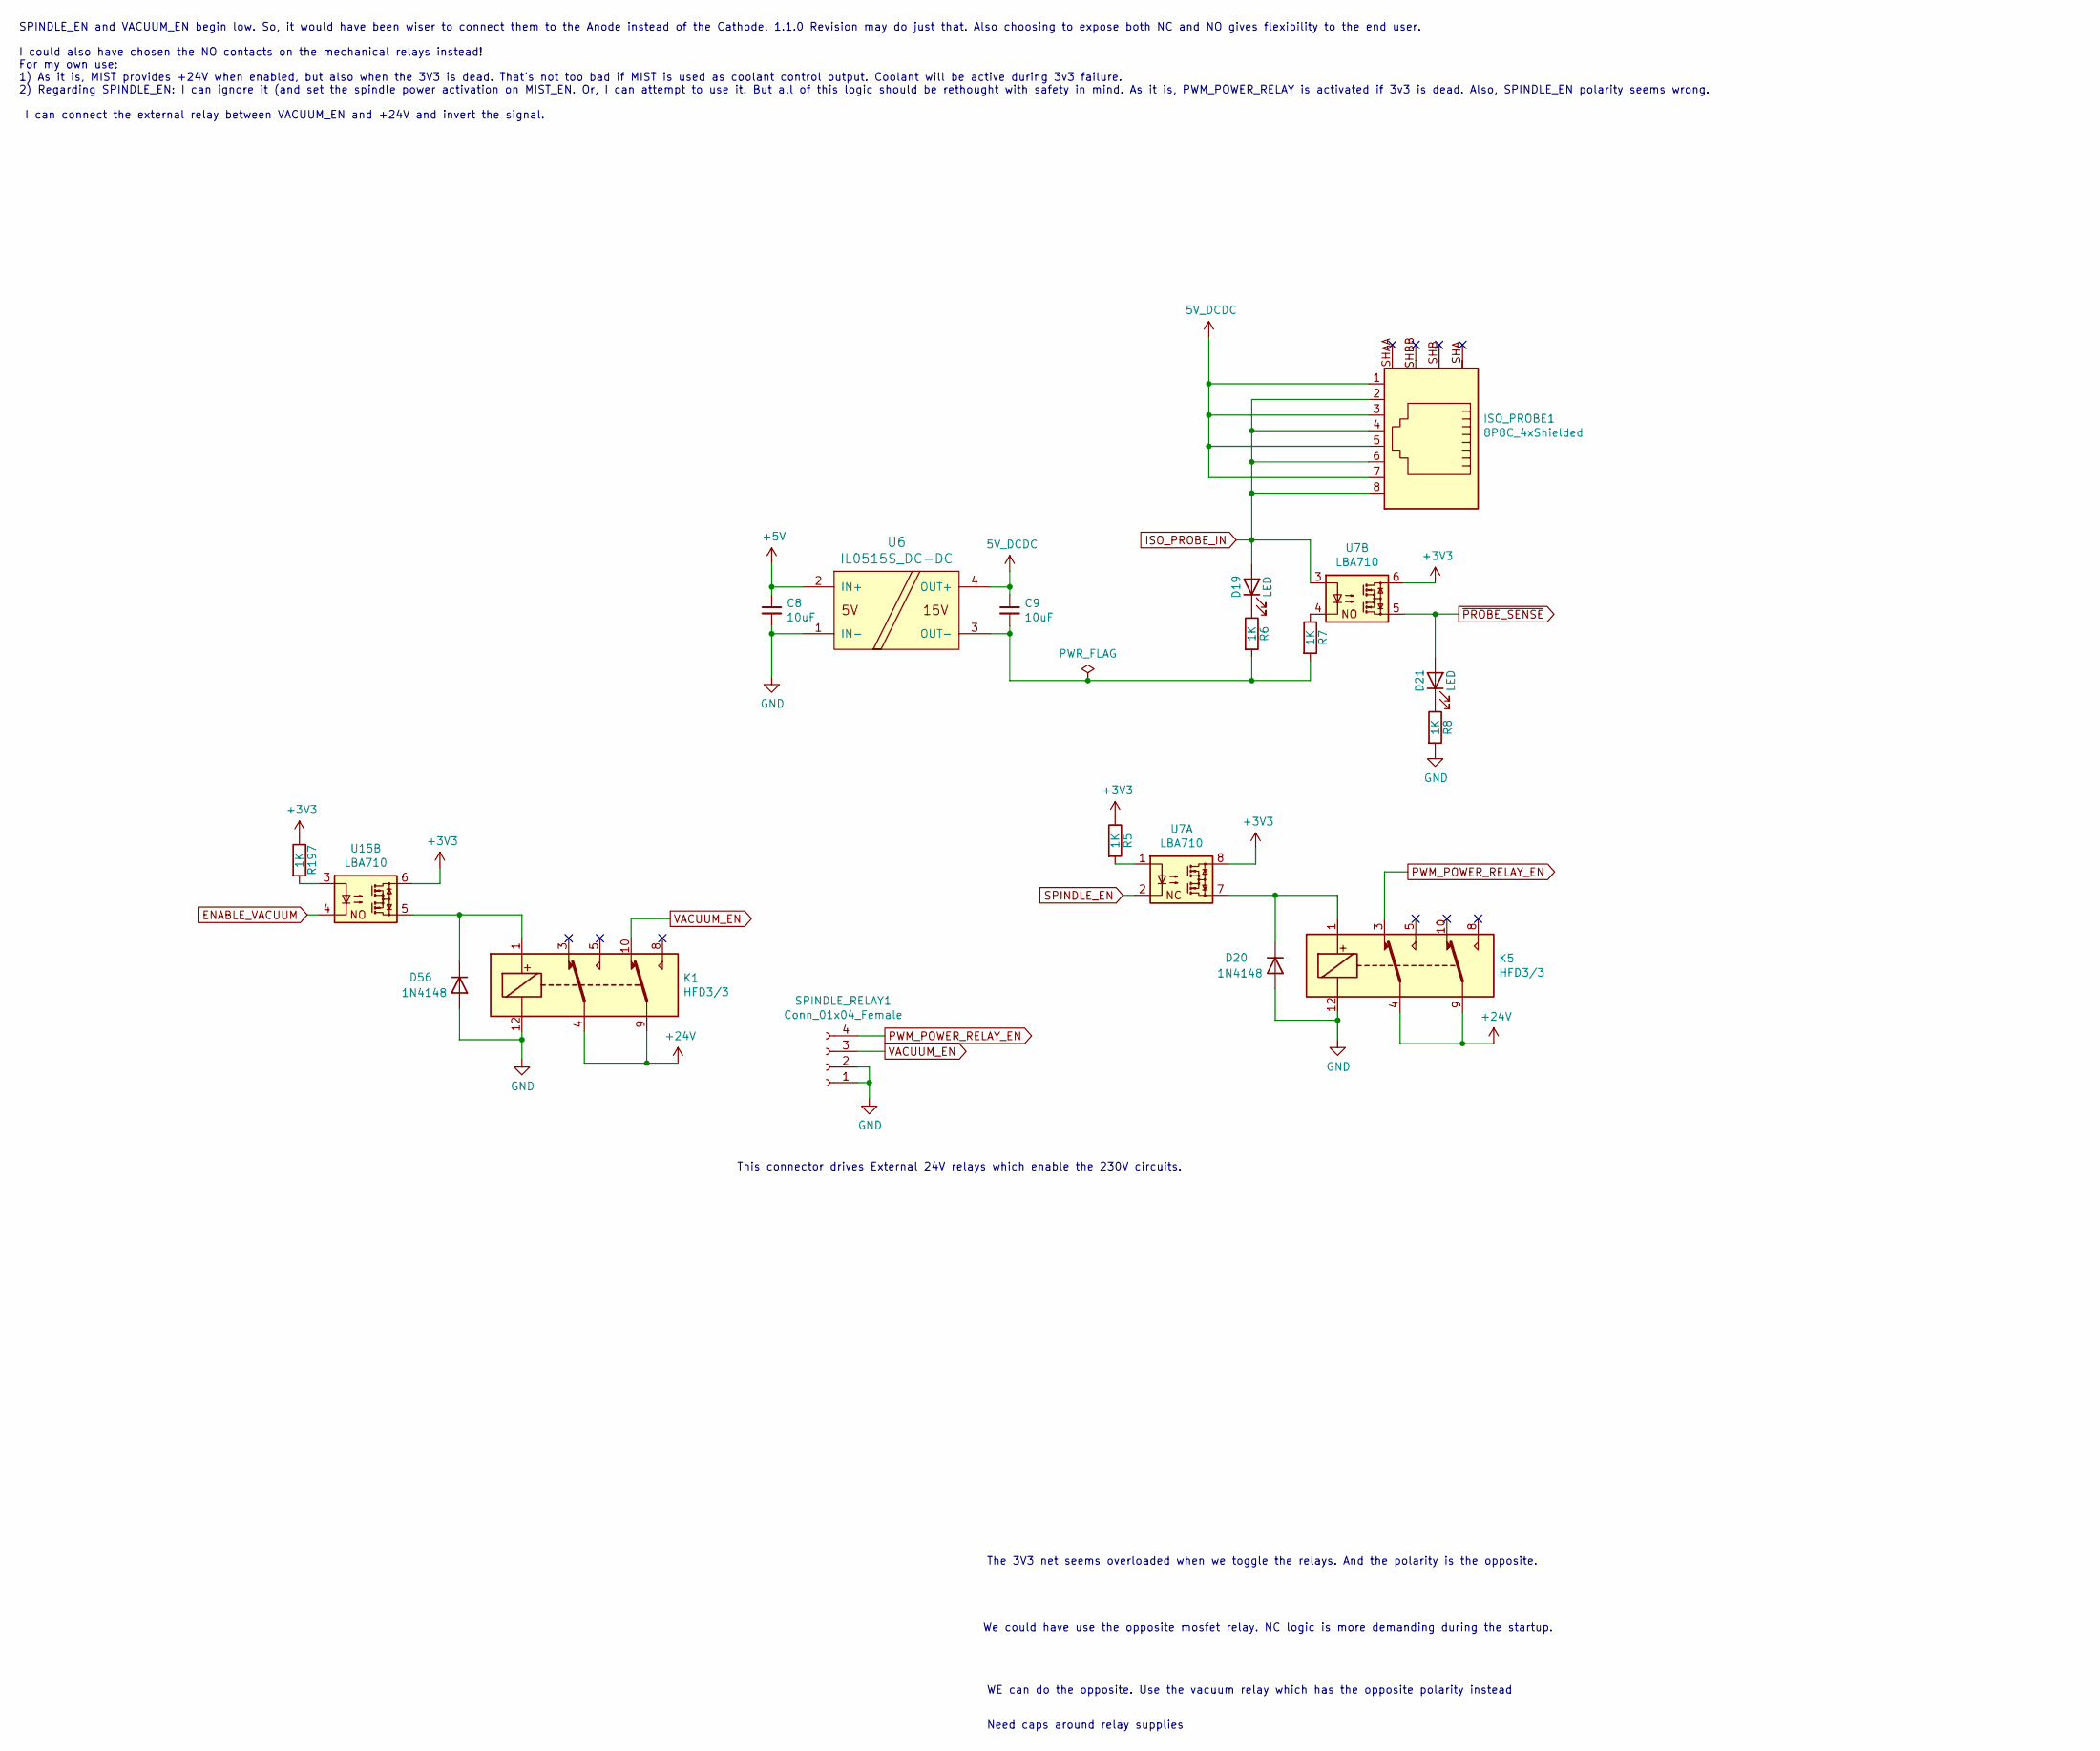
[picture p25: schematic probe.sch]

Parts:
C8, C9: 10uF; C_1206_3216Metric; jlcpcb C13585
D19, D21: LED; D_0805_2012Metric; jlcpcb C84256
D20, D56: 1N4148; D_SOD-123; jlcpcb C81598
ISO_PROBE1: 8P8C_4xShielded; rj45_R-RJ45S08P-B000_C386763; jlcpcb DNP007
K1, K5: HFD3/3; Relay_DPDT_Kemet_EC2; jlcpcb DNP009
R5, R6, R7, R8, R197: 1K; R_0603_1608Metric; jlcpcb C21190
SPINDLE_RELAY1: Conn_01x04_Female; PhoenixContact_MSTBV_2,5_4-GF-5,08_1x04_P5.08mm_Vertical_Th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; jlcpcb DNP012
U6: IL0515S_DC-DC; PinHeader_1x04_P2.54mm_Vertical; jlcpcb DNP013
U7, U15: LBA710; DIP-8_W8.89mm_SMDSocket_LongPads; jlcpcb DNP014

Connections:
5V_DCDC: C9.1, ISO_PROBE1.1, ISO_PROBE1.3, ISO_PROBE1.5, ISO_PROBE1.7, U6.4 (OUT+)
+3V3: R5.1, R197.1, U7.6, U7.8, U15.6
+5V: C8.1, U6.2 (IN+)
+24V: K1.4, K1.9, K5.4, K5.9
ENABLE_VACUUM: U15.4
GND: C8.2, D20.2 (A), D56.2 (A), K1.12, K5.12, R8.2, SPINDLE_RELAY1.1, SPINDLE_RELAY1.2, U6.1 (IN-)
ISO_PROBE_IN: D19.2 (A), ISO_PROBE1.2, ISO_PROBE1.4, ISO_PROBE1.6, ISO_PROBE1.8, U7.3
unnamed: C9.2, R6.2, R7.2, U6.3 (OUT-)
unnamed: D19.1 (K), R6.1
unnamed: D20.1 (K), K5.1, U7.7
unnamed: D21.1 (K), R8.1
unnamed: D56.1 (K), K1.1, U15.5
unnamed: R5.2, U7.1
unnamed: R7.1, U7.4
unnamed: R197.2, U15.3
PWM_POWER_RELAY_EN: K5.3, SPINDLE_RELAY1.4
SPINDLE_EN: U7.2
VACUUM_EN: K1.10, SPINDLE_RELAY1.3
~PROBE_SENSE: D21.2 (A), U7.5

Notes on the sheet:
This connector drives External 24V relays which enable the 230V circuits.
The 3V3 net seems overloaded when we toggle the relays. And the polarity is the opposite.
We could have use the opposite mosfet relay. NC logic is more demanding during the startup.
WE can do the opposite. Use the vacuum relay which has the opposite polarity instead
Need caps around relay supplies
SPINDLE_EN and VACUUM_EN begin low. So, it would have been wiser to connect them to the Anode instead of the Cathode. 1.1.0 Revision may do just that. Also choosing to expose both NC and NO gives flexibility to the end user. I could also have chosen the NO contacts on the mechanical relays instead!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
