spsspssps/spscnc/hw/spscnc/psu5v.sch

## KiCad design hw/spscnc/psu5v.sch (2022-04-29)

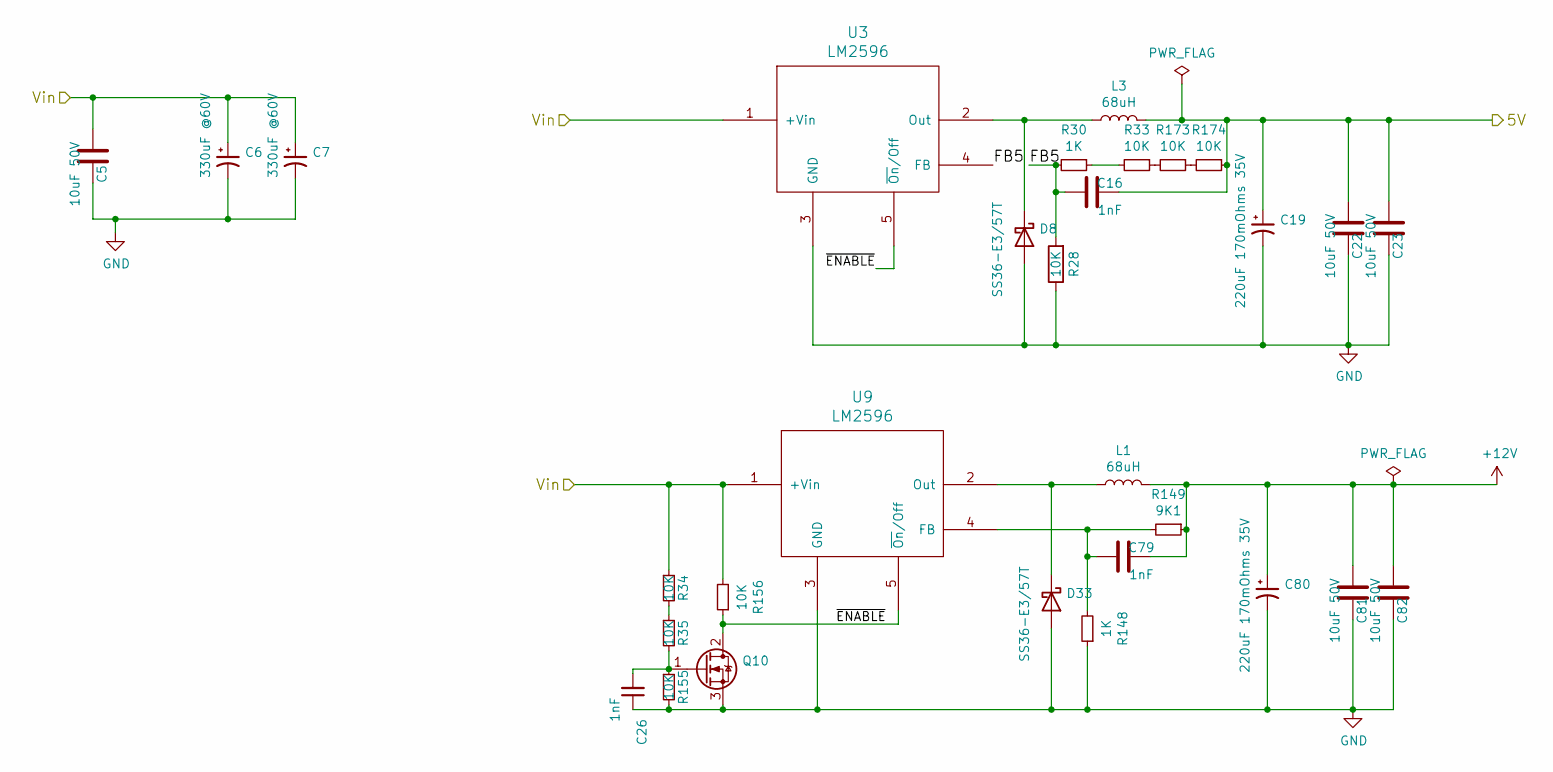
[picture p26: schematic psu5v.sch]

Parts:
C4, C81, C82, C104, C109: 10uF 50V; C_1210_3225Metric; jlcpcb C77102
C5, C16: 330uF @60V; CP_Radial_D24.0mm_P10.00mm_SnapIn; jlcpcb DNP015
C12, C80: 220uF 170mOhms 35V; CP_Elec_8x10; jlcpcb C311610
C26, C79: 1nF; C_0805_2012Metric; jlcpcb C46653
D18, D33: SS36-E3/57T; D_SMC; jlcpcb HOMESTOK444
L1: 68uH; L_12x12mm_H8mm; jlcpcb STOCK104
Q10: KIA50N06B; TO-252-2; jlcpcb C130980
R33, R34, R35, R155, R156, R173, R174, R403: 10K; R_0805_2012Metric; jlcpcb C17414
R148, R406: 1K; R_0603_1608Metric; jlcpcb C21190
R149: 9K1; R_0603_1608Metric; jlcpcb C23260
U9, U21: LM2596; TO-263-5_TabPin3; jlcpcb DNP019

Connections:
5V: C12.1, C26.1, C104.2, C109.2, L1.2, R174.1
+12V: C79.1, C80.1, C81.2, C82.2, L1.2, R149.1
FB5: C26.2, R403.2, R406.2, U21.4 (FB)
GND: C4.1, C5.2, C12.2, C16.2, C26.1, C80.2, C81.1, C82.1, C104.1, C109.1, D18.2 (A), D33.2 (A), Q10.3 (S), R148.1, R155.2, R403.1, U9.3 (GND), U21.3 (GND)
unnamed: C26.2, Q10.1 (G), R35.2, R155.1
unnamed: C79.2, R148.2, R149.2, U9.4 (FB)
unnamed: D18.1 (K), L1.1, U21.2 (Out)
unnamed: D33.1 (K), L1.1, U9.2 (Out)
unnamed: R33.2, R406.1
unnamed: R34.2, R35.1
unnamed: R173.1, R174.2
unnamed: R33.1, R173.2
Vin: C4.2, C5.1, C16.1, R34.1, R156.2, U9.1 (+Vin), U21.1 (+Vin)
~ENABLE: Q10.2 (D), R156.1, U9.5 (~On~/Off), U21.5 (~On~/Off)
