spsspssps/spscnc/hw/spscnc/psu.sch

## KiCad design hw/spscnc/psu.sch (2022-04-29)

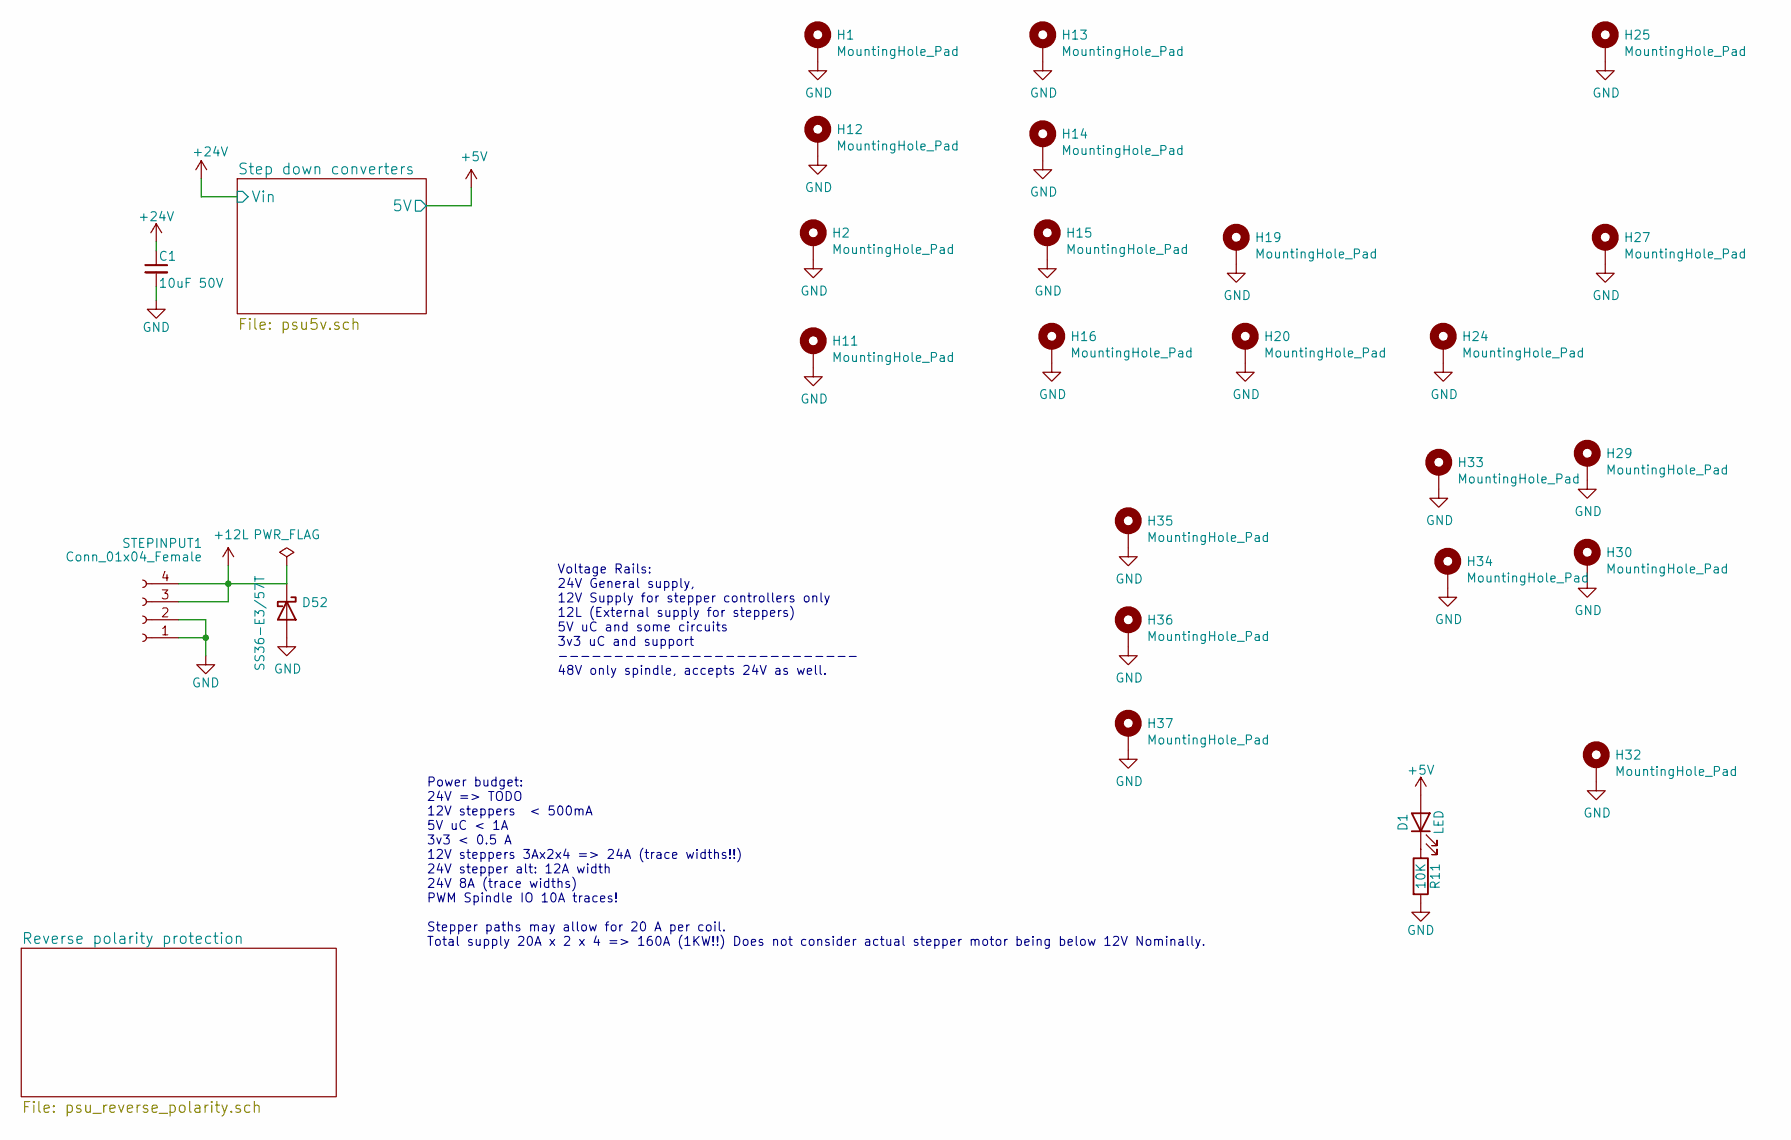
[picture p27: schematic psu.sch]

Parts:
C1: 10uF 50V; C_1210_3225Metric; jlcpcb C77102
D13: LED; D_0805_2012Metric; jlcpcb C84256
D52: SS36-E3/57T; D_SMC; jlcpcb HOMESTOK444
H1, H2, H11, H12, H13, H14, H15, H16, H19, H20, H24, H25, H27, H29, H30, H32, H33, H34, H35, H36, H37: MountingHole_Pad; MountingHole_3.2mm_M3_Pad_Via; jlcpcb DNP003
R41: 10K; R_0805_2012Metric; jlcpcb C17414
STEPINPUT1: Conn_01x04_Female; PhoenixContact_MSTBV_2,5_4-GF-5,08_1x04_P5.08mm_Vertical_Th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; jlcpcb DNP006

Connections:
+5V: D13.2 (A)
+12L: D52.1 (K), STEPINPUT1.3, STEPINPUT1.4
+24V: C1.1
GND: C1.2, D52.2 (A), H1.1, H2.1, H11.1, H12.1, H13.1, H14.1, H15.1, H16.1, H19.1, H20.1, H24.1, H25.1, H27.1, H29.1, H30.1, H32.1, H33.1, H34.1, H35.1, H36.1, H37.1, R41.2, STEPINPUT1.1, STEPINPUT1.2
unnamed: D13.1 (K), R41.1

Notes on the sheet:
Voltage Rails: 24V General supply, 12V Supply for stepper controllers only 12L (External supply for steppers) 5V uC and some circuits 3v3 uC and support --------------------------- 48V only spindle, accepts 24V as well.
Power budget: 24V => TODO 12V steppers < 500mA 5V uC < 1A 3v3 < 0.5 A 12V steppers 3Ax2x4 => 24A (trace widths!!) 24V stepper alt: 12A width 24V 8A (trace widths) PWM Spindle IO 10A traces! Stepper paths may allow for 20 A per coil. Total supply 20A x 2 x 4 => 160A (1KW!!) Does not consider actual 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
