spsspssps/spscnc/hw/spscnc/psu_reverse_polarity.sch

## KiCad design hw/spscnc/psu_reverse_polarity.sch (2022-04-29)

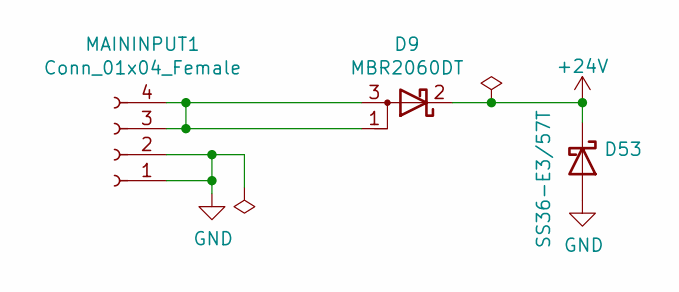
[picture p28: schematic psu_reverse_polarity.sch]

Parts:
D9: MBR2060DT; TO-252-2; jlcpcb C668181
D53: SS36-E3/57T; D_SMC; jlcpcb HOMESTOK444
MAININPUT1: Conn_01x04_Female; PhoenixContact_MSTBV_2,5_4-GF-5,08_1x04_P5.08mm_Vertical_Th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; jlcpcb DNP005

Connections:
+24V: D9.2 (K), D53.1 (K)
GND: D53.2 (A), MAININPUT1.1, MAININPUT1.2
unnamed: D9.1 (A), D9.3 (A), MAININPUT1.3, MAININPUT1.4
