spsspssps/spscnc/hw/spscnc/spindle.sch

## KiCad design hw/spscnc/spindle.sch (2022-04-29)

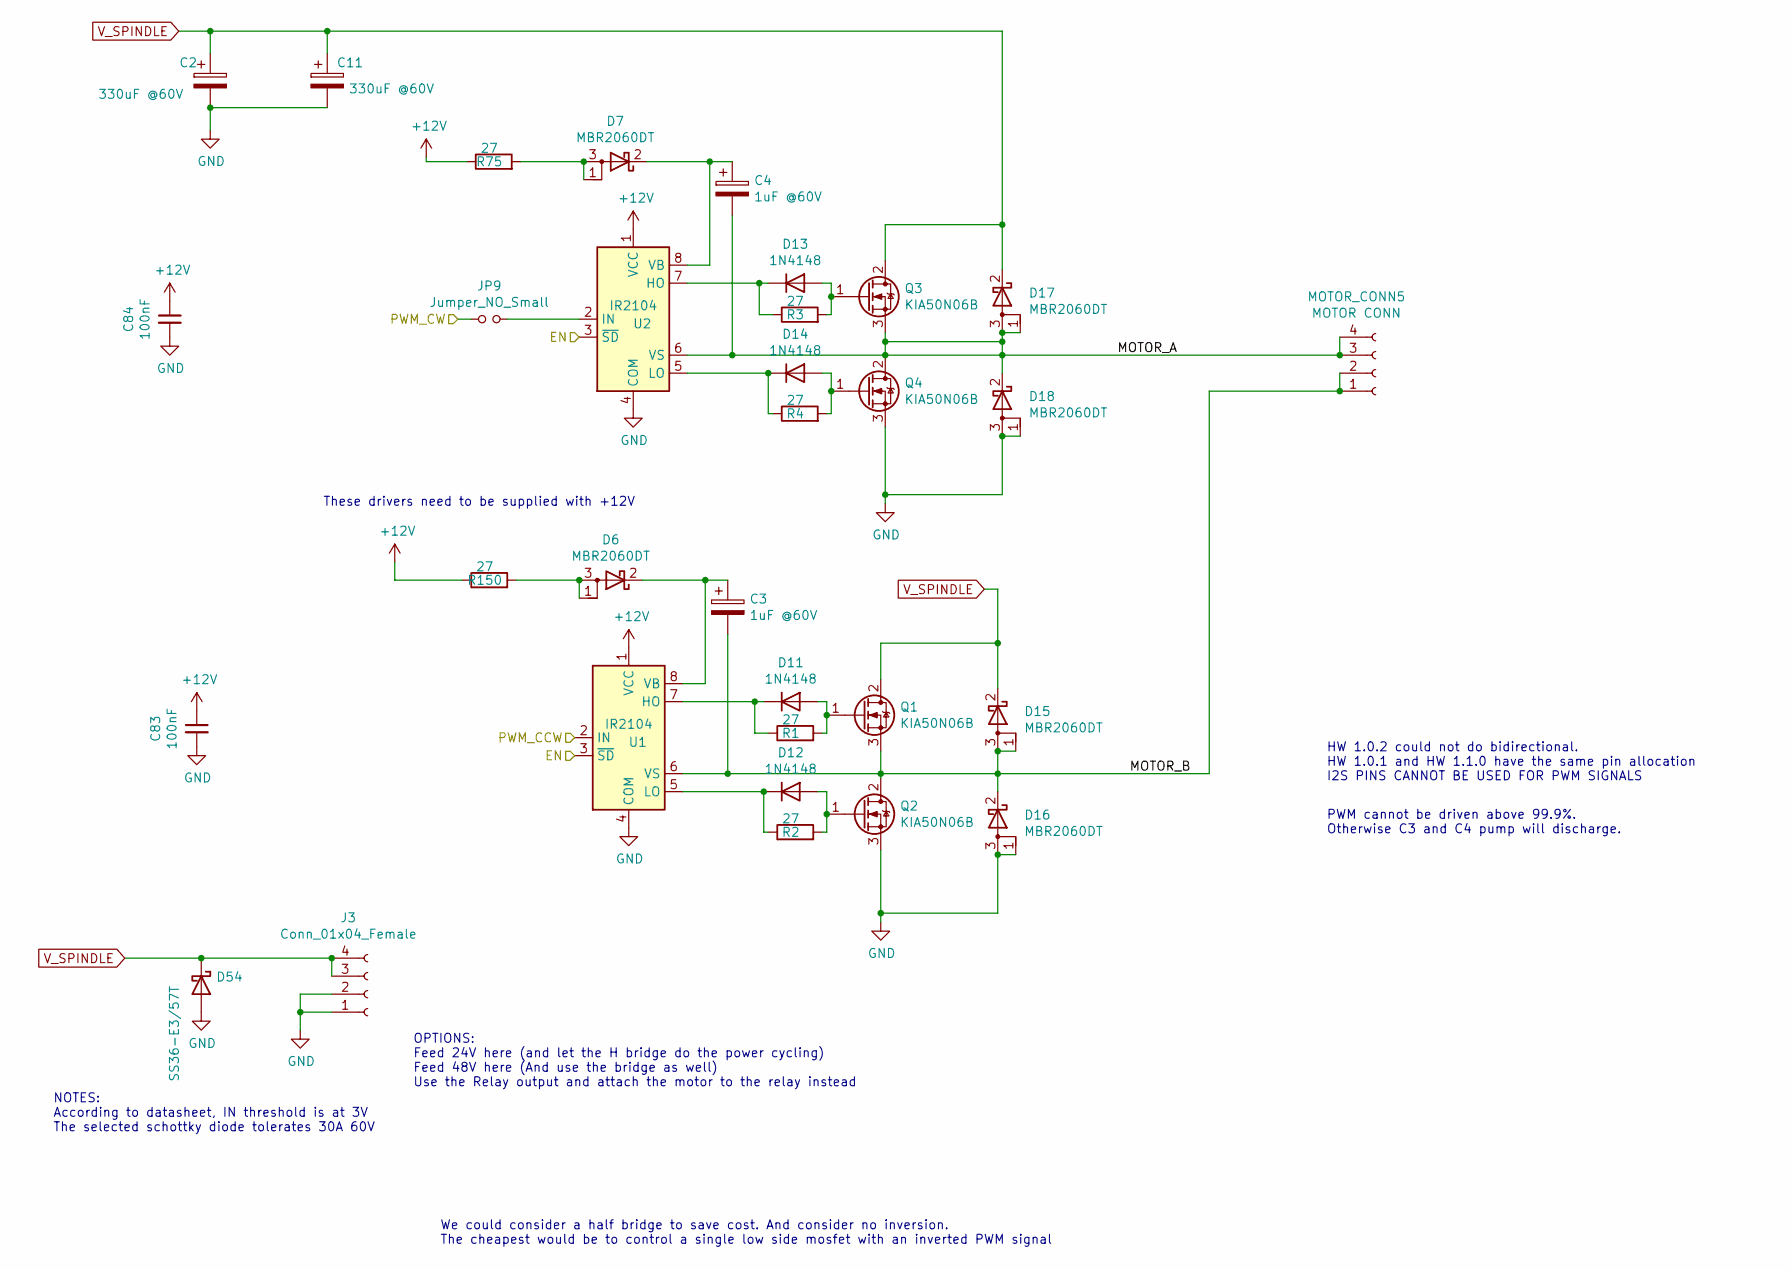
[picture p29: schematic spindle.sch]

Parts:
C2, C11: 330uF @60V; CP_Radial_D24.0mm_P10.00mm_SnapIn; jlcpcb DNP015
C3, C4: 1uF @60V; CP_Elec_5x5.7; jlcpcb C487554
C83, C84: 100nF; C_0603_1608Metric; jlcpcb C14663
D6, D7, D15, D16, D17, D18: MBR2060DT; TO-252-2; jlcpcb C668181
D11, D12, D13, D14: 1N4148; D_SOD-123; jlcpcb C81598
D54: SS36-E3/57T; D_SMC; jlcpcb HOMESTOK444
J3: Conn_01x04_Female; PhoenixContact_MSTBV_2,5_4-GF-5,08_1x04_P5.08mm_Vertical_Th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; jlcpcb DNP004
JP9: Jumper_NO_Small; PinHeader_1x02_P2.54mm_Vertical; jlcpcb DNP443
MOTOR_CONN5: MOTOR CONN; PhoenixContact_MSTBV_2,5_4-GF-5,08_1x04_P5.08mm_Vertical_Th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; jlcpcb DNP006
Q1, Q2, Q3, Q4: KIA50N06B; TO-252-2; jlcpcb C130980
R1, R2, R3, R4, R75, R150: 27; R_0805_2012Metric; jlcpcb C17594
U1, U2: IR2104; SOIC-8_3.9x4.9mm_P1.27mm; jlcpcb C2960

Connections:
+12V: C83.1, C84.1, R75.1, R150.1, U1.1 (VCC), U2.1 (VCC)
EN: U1.3 (~SD), U2.3 (~SD)
GND: C2.2, C11.2, C83.2, C84.2, D16.1 (A), D16.3 (A), D18.1 (A), D18.3 (A), D54.2 (A), J3.1, J3.2, Q2.3 (S), Q4.3 (S), U1.4 (COM), U2.4 (COM)
MOTOR_A: C4.2, D17.1 (A), D17.3 (A), D18.2 (K), MOTOR_CONN5.3, MOTOR_CONN5.4, Q3.3 (S), Q4.2 (D), U2.6 (VS)
MOTOR_B: C3.2, D15.1 (A), D15.3 (A), D16.2 (K), MOTOR_CONN5.1, MOTOR_CONN5.2, Q1.3 (S), Q2.2 (D), U1.6 (VS)
unnamed: C3.1, D6.2 (K), U1.8 (VB)
unnamed: C4.1, D7.2 (K), U2.8 (VB)
unnamed: D6.1 (A), D6.3 (A), R150.2
unnamed: D7.1 (A), D7.3 (A), R75.2
unnamed: D11.1 (K), R1.1, U1.7 (HO)
unnamed: D11.2 (A), Q1.1 (G), R1.2
unnamed: D12.1 (K), R2.1, U1.5 (LO)
unnamed: D12.2 (A), Q2.1 (G), R2.2
unnamed: D13.1 (K), R3.1, U2.7 (HO)
unnamed: D13.2 (A), Q3.1 (G), R3.2
unnamed: D14.1 (K), R4.1, U2.5 (LO)
unnamed: D14.2 (A), Q4.1 (G), R4.2
unnamed: JP9.2, U2.2 (IN)
PWM_CCW: U1.2 (IN)
PWM_CW: JP9.1
V_SPINDLE: C2.1, C11.1, D15.2 (K), D17.2 (K), D54.1 (K), J3.3, J3.4, Q1.2 (D), Q3.2 (D)

Notes on the sheet:
NOTES: According to datasheet, IN threshold is at 3V The selected schottky diode tolerates 30A 60V
We could consider a half bridge to save cost. And consider no inversion. The cheapest would be to control a single low side mosfet with an inverted PWM signal
OPTIONS: Feed 24V here (and let the H bridge do the power cycling) Feed 48V here (And use the bridge as well) Use the Relay output and attach the motor to the relay instead
PWM cannot be driven above 99.9%. Otherwise C3 and C4 pump will discharge.
These drivers need to be supplied with +12V
HW 1.0.2 could not do bidirectional. HW 1.0.1 and HW 1.1.0 have the same pin allocation I2S PINS CANNOT BE USED FOR PWM SIGNALS
