spsspssps/spscnc/hw/spscnc/spscnc.sch

## KiCad design hw/spscnc/spscnc.sch (2022-04-29)

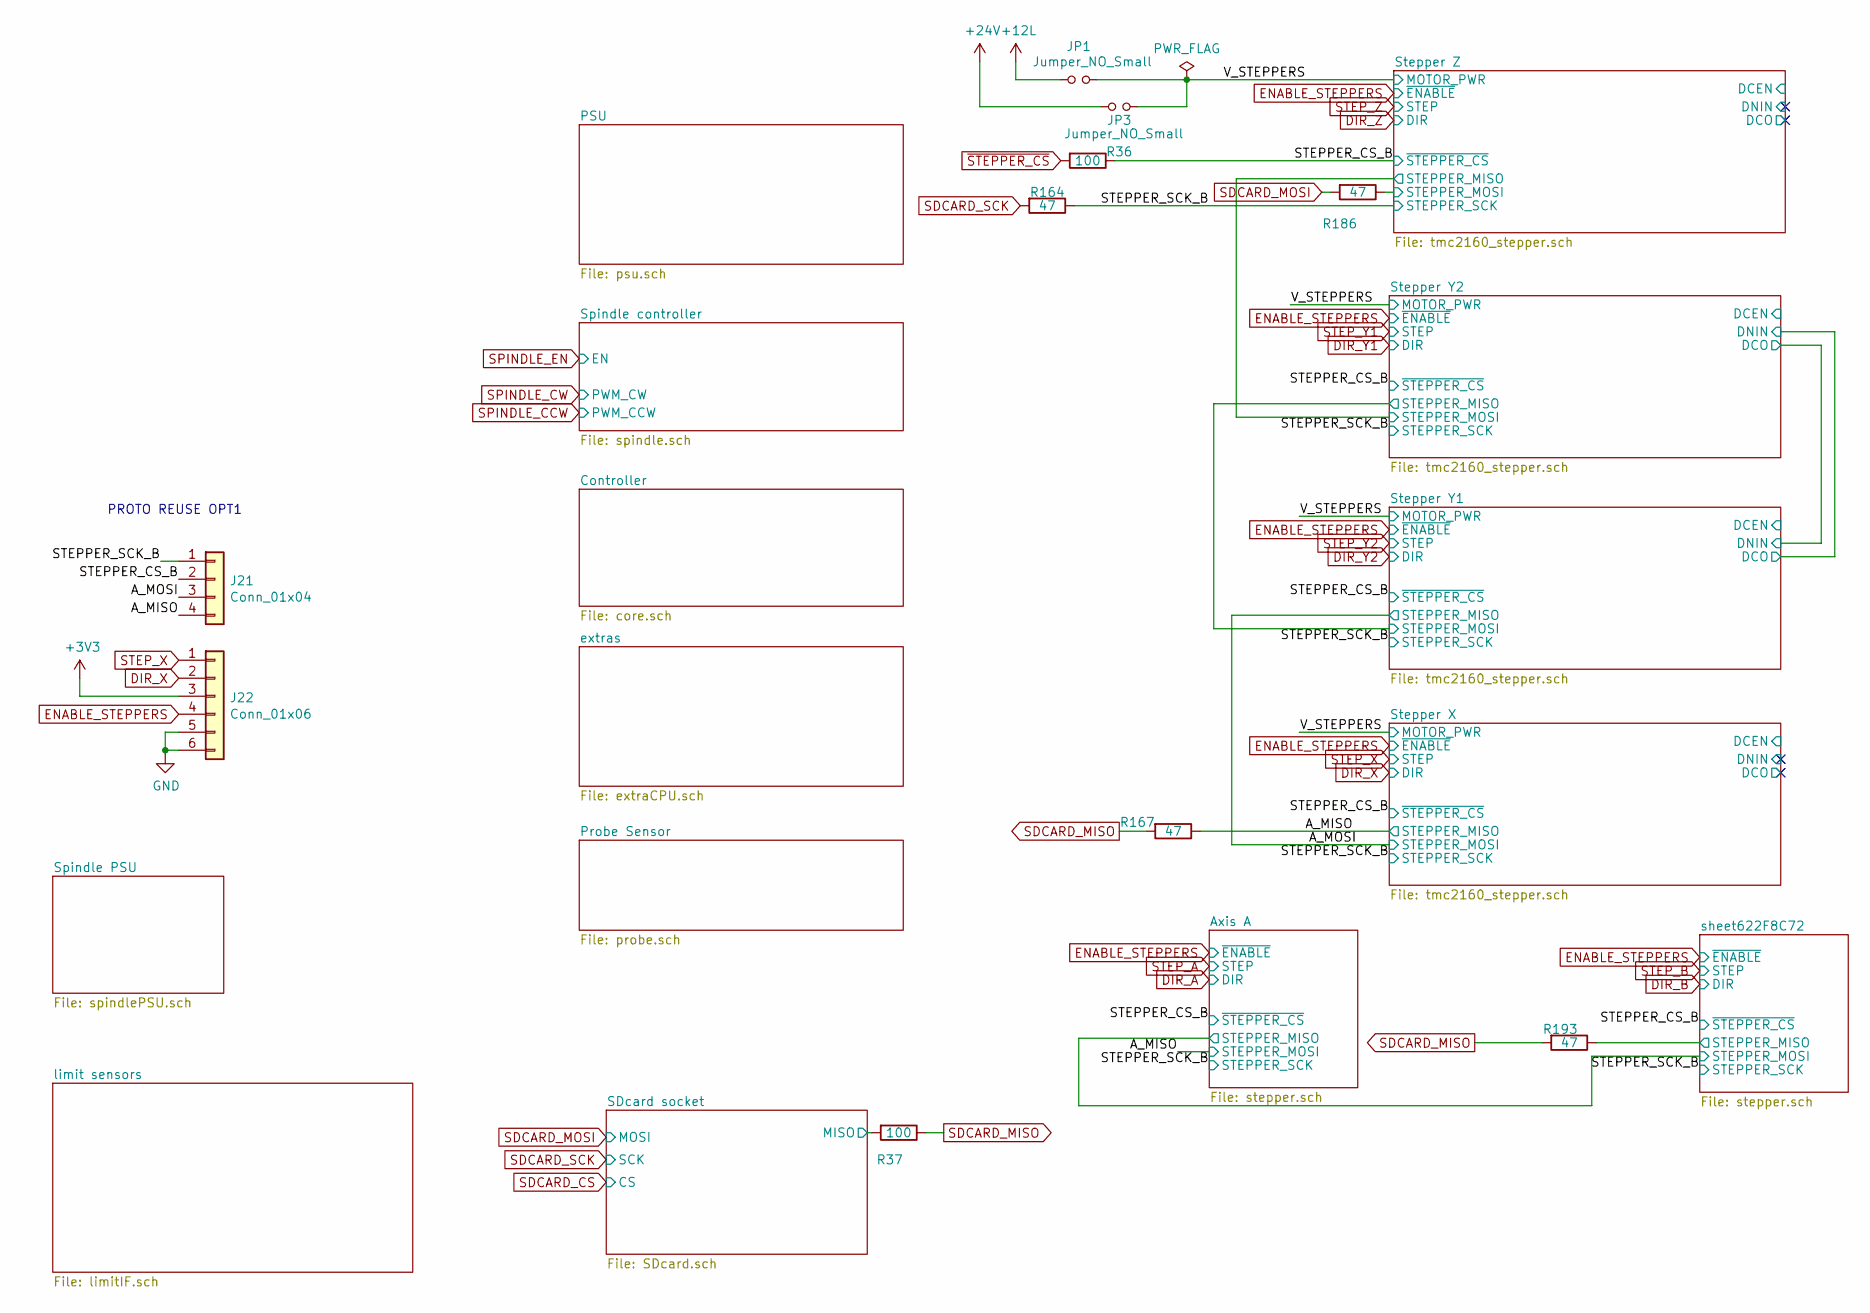
[picture p30: schematic spscnc.sch]

Parts:
J21: Conn_01x04; PinHeader_1x04_P2.54mm_Vertical; jlcpcb DNP008
J22: Conn_01x06; PinHeader_1x06_P2.54mm_Vertical; jlcpcb DNP562
JP1: Jumper_NO_Small; SolderJumper-2_P1.3mm_Open_Pad1.0x1.5mm; jlcpcb DNP023
JP3: Jumper_NO_Small; PinHeader_1x02_P2.54mm_Vertical; jlcpcb DNP443
R36, R37: 100; R_0805_2012Metric; jlcpcb C17408
R164, R167, R186, R193: 47; R_0805_2012Metric; jlcpcb C17714

Connections:
+3V3: J22.3
+12L: JP1.1
+24V: JP3.1
A_MISO: J21.4, R167.1
A_MOSI: J21.3
DIR_X: J22.2
ENABLE_STEPPERS: J22.4
GND: J22.5, J22.6
MISO: R37.2
SDCARD_MISO: R37.1, R167.2, R193.2
SDCARD_MOSI: R186.2
SDCARD_SCK: R164.2
STEPPER_CS_B: J21.2, R36.1
STEPPER_MISO: R193.1
STEPPER_MOSI: R186.1
STEPPER_SCK_B: J21.1, R164.1
STEP_X: J22.1
V_STEPPERS: JP1.2, JP3.2
~STEPPER_CS: R36.2

Notes on the sheet:
PROTO REUSE OPT1
