spsspssps/spscnc/hw/spscnc/stepper.sch

## KiCad design hw/spscnc/stepper.sch (2022-04-29)

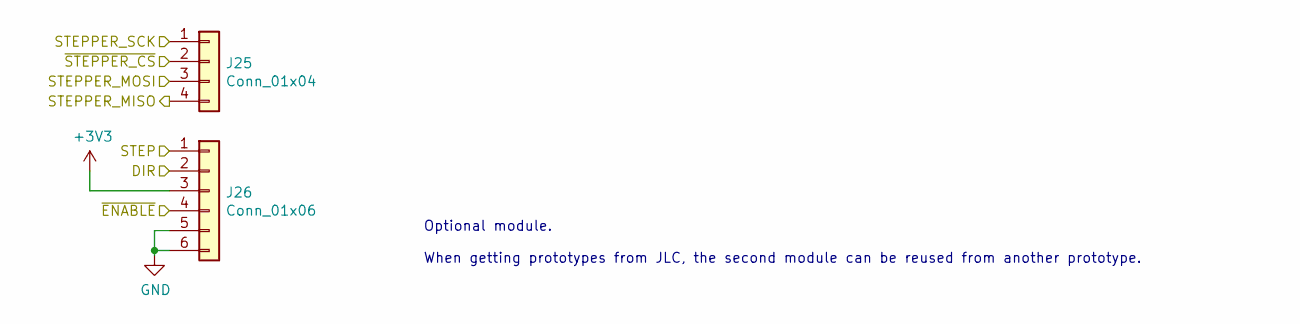
[picture p31: schematic stepper.sch]

Parts:
J23: Conn_01x04; PinHeader_1x04_P2.54mm_Vertical; jlcpcb DNP008
J24: Conn_01x06; PinHeader_1x06_P2.54mm_Vertical; jlcpcb DNP562

Connections:
+3V3: J24.3
DIR: J24.2
GND: J24.5, J24.6
STEP: J24.1
STEPPER_MISO: J23.4
STEPPER_MOSI: J23.3
STEPPER_SCK: J23.1
~ENABLE: J24.4
~STEPPER_CS: J23.2

Notes on the sheet:
Optional module. When getting prototypes from JLC, the second module can be reused from another prototype.
