spsspssps/spscnc/hw/spscnc/tmc2160_stepper.sch

## KiCad design hw/spscnc/tmc2160_stepper.sch (2022-04-29)

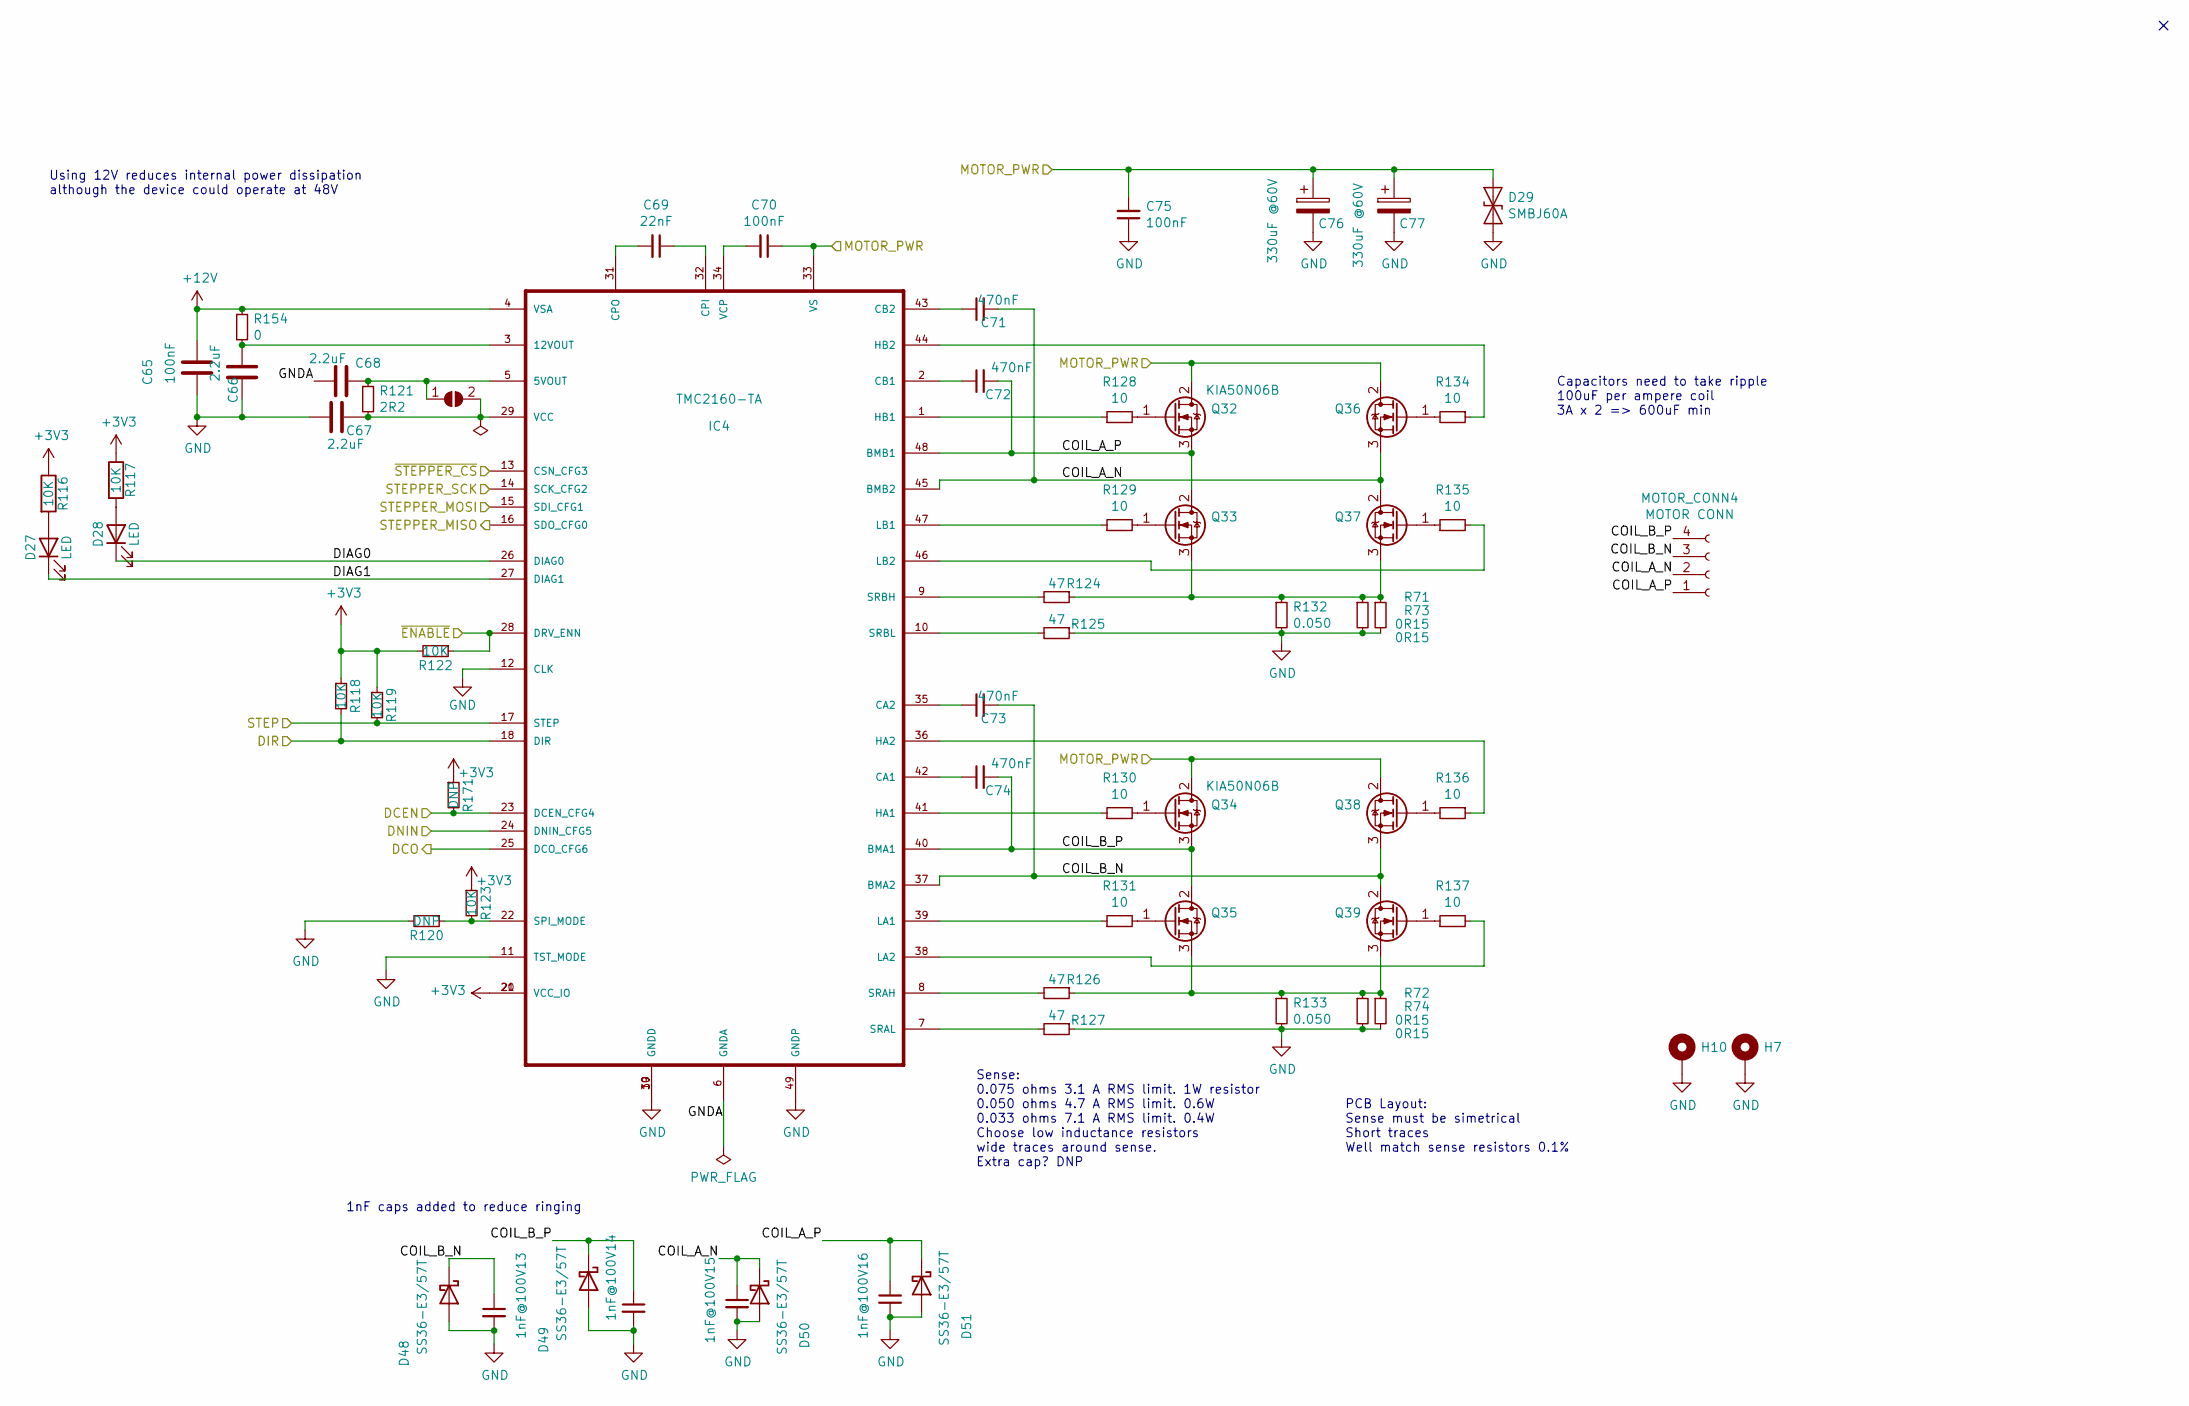
[picture p32: schematic tmc2160_stepper.sch]

Parts:
1nF@100V1, 1nF@100V2, 1nF@100V3, 1nF@100V4: 1nF; C_0805_2012Metric; jlcpcb C15177
C12, C18, C24: 100nF; C_0603_1608Metric; jlcpcb C14663
C13, C14, C15: 2.2uF; C_0805_2012Metric; jlcpcb C49217
C17: 22nF; C_0805_2012Metric; jlcpcb C273670
C20, C21, C34, C35: 470nF; C_0805_2012Metric; jlcpcb C0805
C25, C40: 330uF @60V; CP_Radial_D24.0mm_P10.00mm_SnapIn; jlcpcb DNP015
D2, D3: LED; D_0805_2012Metric; jlcpcb C84256
D4: SMBJ60A; D_SMB; jlcpcb C440310
D36, D37, D38, D39: SS36-E3/57T; D_SMC; jlcpcb HOMESTOK444
H3, H4: MountingHole_Pad; MountingHole_3.2mm_M3_Pad_Via; jlcpcb DNP003
IC1: TMC2160-TA; TQFP-48-1EP_7x7mm_P0.5mm_EP5x5mm; jlcpcb C465948
JP4: SolderJumper_2_Open; SolderJumper-2_P1.3mm_Open_Pad1.0x1.5mm; jlcpcb DNP_NA1
MOTOR_CONN1: MOTOR CONN; PhoenixContact_MSTBV_2,5_4-GF-5,08_1x04_P5.08mm_Vertical_Th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; jlcpcb DNP006
Q5, Q6, Q7, Q8, Q9, Q13, Q14, Q15: KIA50N06B; TO-252-2; jlcpcb C130980
R9, R10, R12, R13, R16, R17: 10K; R_0805_2012Metric; jlcpcb C17414
R14: DNP; R_0603_1608Metric; jlcpcb DNP010
R15: 2R2; R_0805_2012Metric; jlcpcb C17477
R18, R19, R25, R26: 47; R_0805_2012Metric; jlcpcb C17714
R20, R21, R23, R24, R27, R29, R32, R48: 10; R_0805_2012Metric; jlcpcb C17415
R22, R31: 0.050; R_2512_6332Metric; jlcpcb HOME050
R38, R39, R40, R41: 0R15; R_MELF_MMB-0207; jlcpcb HOMESTOCK00
R151: 0; R_0805_2012Metric; jlcpcb C17477
R168: DNP; R_0805_2012Metric; jlcpcb DNP734

Connections:
+3V3: IC1.20 (VCC_IO), IC1.21 (VCC_IO), R9.1, R10.1, R12.1, R13.1, R16.2, R17.1, R168.1
+12V: C12.2, IC1.4 (VSA), R151.1
COIL_A_N: 1nF@100V3.1, C20.2, D38.1 (K), IC1.45 (BMB2), MOTOR_CONN1.2, Q7.3 (S), Q8.2 (D)
COIL_A_P: 1nF@100V4.1, C21.2, D39.1 (K), IC1.48 (BMB1), MOTOR_CONN1.1, Q5.3 (S), Q6.2 (D)
COIL_B_N: 1nF@100V1.1, C34.2, D36.1 (K), IC1.37 (BMA2), MOTOR_CONN1.3, Q14.3 (S), Q15.2 (D)
COIL_B_P: 1nF@100V2.1, C35.2, D37.1 (K), IC1.40 (BMA1), MOTOR_CONN1.4, Q9.3 (S), Q13.2 (D)
DCEN: IC1.23 (DCEN_CFG4), R168.2
DCO: IC1.25 (DCO_CFG6)
DIAG0: D3.1 (K), IC1.26 (DIAG0)
DIAG1: D2.1 (K), IC1.27 (DIAG1)
DIR: IC1.18 (DIR), R12.2
DNIN: IC1.24 (DNIN_CFG5)
GND: 1nF@100V1.2, 1nF@100V2.2, 1nF@100V3.2, 1nF@100V4.2, C12.1, C13.2, C15.1, C24.1, C25.2, C40.2, D4.2 (A2), D36.2 (A), D37.2 (A), D38.2 (A), D39.2 (A), H3.1, H4.1, IC1.11 (TST_MODE), IC1.12 (CLK), IC1.19 (GNDD), IC1.30 (GNDD), IC1.49 (GNDP), R14.2, R19.1, R22.2, R26.1, R31.2, R38.2, R39.2, R40.2, R41.2
GNDA: C14.2, IC1.6 (GNDA)
MOTOR_PWR: C18.1, C24.2, C25.1, C40.1, D4.1 (A1), IC1.33 (VS), Q5.2 (D), Q7.2 (D), Q9.2 (D), Q14.2 (D)
unnamed: C13.1, IC1.29 (VCC), JP4.2 (B), R15.2
unnamed: C14.1, IC1.5 (5VOUT), JP4.1 (A), R15.1
unnamed: C15.2, IC1.3 (12VOUT), R151.2
unnamed: C17.1, IC1.32 (CPI)
unnamed: C17.2, IC1.31 (CPO)
unnamed: C18.2, IC1.34 (VCP)
unnamed: C20.1, IC1.43 (CB2)
unnamed: C21.1, IC1.2 (CB1)
unnamed: C34.1, IC1.35 (CA2)
unnamed: C35.1, IC1.42 (CA1)
unnamed: D2.2 (A), R9.2
unnamed: D3.2 (A), R10.2
unnamed: IC1.1 (HB1), R20.1
unnamed: IC1.7 (SRAL), R26.2
unnamed: IC1.8 (SRAH), R25.2
unnamed: IC1.9 (SRBH), R18.2
unnamed: IC1.10 (SRBL), R19.2
unnamed: IC1.22 (SPI_MODE), R14.1, R17.2
unnamed: IC1.36 (HA2), R32.1
unnamed: IC1.38 (LA2), R48.2
unnamed: IC1.39 (LA1), R29.1
unnamed: IC1.41 (HA1), R27.1
unnamed: IC1.44 (HB2), R23.1
unnamed: IC1.46 (LB2), R24.2
unnamed: IC1.47 (LB1), R21.1
unnamed: Q5.1 (G), R20.2
unnamed: Q6.1 (G), R21.2
unnamed: Q6.3 (S), Q8.3 (S), R18.1, R22.1, R38.1, R40.1
unnamed: Q7.1 (G), R23.2
unnamed: Q8.1 (G), R24.1
unnamed: Q9.1 (G), R27.2
unnamed: Q13.1 (G), R29.2
unnamed: Q13.3 (S), Q15.3 (S), R25.1, R31.1, R39.1, R41.1
unnamed: Q14.1 (G), R32.2
unnamed: Q15.1 (G), R48.1
STEP: IC1.17 (STEP), R13.2
STEPPER_MISO: IC1.16 (SDO_CFG0)
STEPPER_MOSI: IC1.15 (SDI_CFG1)
STEPPER_SCK: IC1.14 (SCK_CFG2)
~ENABLE: IC1.28 (DRV_ENN), R16.1
~STEPPER_CS: IC1.13 (CSN_CFG3)

Notes on the sheet:
Using 12V reduces internal power dissipation although the device could operate at 48V
Sense: 0.075 ohms 3.1 A RMS limit. 1W resistor 0.050 ohms 4.7 A RMS limit. 0.6W 0.033 ohms 7.1 A RMS limit. 0.4W Choose low inductance resistors wide traces around sense. Extra cap? DNP
PCB Layout: Sense must be simetrical Short traces Well match sense resistors 0.1%
Capacitors need to take ripple 100uF per ampere coil 3A x 2 => 600uF min
1nF caps added to reduce ringing
