spsspssps/spscnc/hw/spscnc/vacuum.sch

## KiCad design hw/spscnc/vacuum.sch (2022-02-06)

Schematic: vacuum.sch

Parts:
J22, J23, J24, J25, J26, J27: Conn_01x03; PinHeader_1x03_P2.54mm_Vertical
K1, K2: AZ850-x; Relay_DPDT_FRT5
Q11, Q12: 2N7002; SOT-23; jlcpcb REPLACE_
R71, R73: 1K; R_0603_1608Metric; jlcpcb C21190
R72, R74: 100K; R_0603_1608Metric; jlcpcb C25803

Notes on the sheet:
230V?? Other relay solution ??
