spsspssps/spscnc/sw/drv8825_card.1.0.0.yaml

name: "ESP32 SPS Controller"
board: "ESP32 SPS Controller"

stepping:
  engine: RMT
  idle_ms: 250
  dir_delay_us: 1
  pulse_us: 2
  disable_delay_us: 0

axes:
  shared_stepper_disable_pin: NO_PIN
  
  z:
  # 5mm per revolution screw pitch
  # drv8825 default 1.8 deg per step.
  # 200 steps per revolution
  # 40 steps per mm
    steps_per_mm: 40
    max_rate_mm_per_min: 160000
    acceleration_mm_per_sec2: 8200
    max_travel_mm: 150
    homing:
      cycle: 3
      mpos_mm: -10
      positive_direction: true
    
    motor0:
      limit_all_pin: gpio.27
      stepstick:
        direction_pin: gpio.25
        step_pin: gpio.26

  y:
    steps_per_mm: 40
    # 66 mm per second => 4000 seems limit for furthest Y rail
    max_rate_mm_per_min: 4000
    # 400
    acceleration_mm_per_sec2: 2200
    #2400
    max_travel_mm: 900
    homing:
      cycle: 1
      mpos_mm: 10
      positive_direction: true
      #false

    motor0:
      limit_all_pin: gpio.34
      stepstick:
        direction_pin: gpio.14:low
        step_pin: gpio.4
    motor1:
      limit_all_pin: gpio.35
      stepstick:
        direction_pin: gpio.13:low
        step_pin: gpio.16
  x:
    steps_per_mm: 40
# Broken motor
#    max_rate_mm_per_min: 400
#    acceleration_mm_per_sec2: 1200
    max_rate_mm_per_min: 20000
    acceleration_mm_per_sec2: 2200
    max_travel_mm: 1200
    homing:
      cycle: 2
      mpos_mm: 10
      positive_direction: false
    motor0:
      limit_all_pin: gpio.36
      stepstick:
        direction_pin: gpio.0
        step_pin: gpio.2

spi:
  miso_pin: gpio.19
  mosi_pin: gpio.23
  sck_pin: gpio.18

sdcard:
  cs_pin: gpio.5
  card_detect_pin: NO_PIN

coolant:
  flood_pin: NO_PIN
  mist_pin:  NO_PIN

        
probe:
  pin: gpio.32:low:pu

PWM:
  pwm_hz: 5000
  output_pin: gpio.21
  enable_pin: gpio.22 
  direction_pin: gpio.17
  disable_with_s0: false
  s0_with_disable: true
  spinup_ms: 0
  spindown_ms: 0
  tool_num: 0
  speed_map: 0=0% 10000=100%


#  0 x.dir: gpio.0
#A 1 GPIO.1 UART
#  2 x.stp: gpio.2
#A 3 GPIO.3 UART
#  4 y1.stp: gpio.4
#  5 spi.cs_pin: gpio.5
#A12 
# 13 y2.dir: gpio.13
# 14 y1.dir: gpio.14
#A15
# 16 y2.stp: gpio.16 gg
# 17 pwm.direction_pin: gpio.17
# 18 spi.sck_pin: gpio.18
# 19 spi.miso_pin: gpio.19
# 21 pwm.output_pin: gpio.21
# 22 pwm.enable_pin: gpio.22 
# 23 spi.mosi_pin: gpio.23
# 25 z.direction_pin: gpio.25
# 26 z.step_pin: gpio.26
# 27 z.limit_all_pin: gpio.27:pu
# 32 probe.pin: gpio.32:low:pu ???
#A33 
# 34 y1.Limit: gpio.34
# 35 y2.Limit: gpio.35
# 36 VP x.limit: gpio.36 gg
# 39 VN
#
#  spi.card_detect_pin: NO_PIN
#

# Available on special module:
# 15, 33
# 36 39 are sensors VP VN (inputs)


# Pins defining BOOT MODES:
# 0 Is high during boot, DIR (OK)
# 2 floating during normal mode. STP normally, should be fine, TEST
# 4 may affect boot, no pullup
# 5 may affect boot, no pullup
# 12 Low during boot (3v3). MTDI flash voltage selection.
# 15 If HIGH during boot (silence mode)

# Pins affected HIGH during BOOT:
# 1 3 5 OK
# 6 - 11 OK
# 14 15  OK
control:
# Change bit: blue :TODO pu once installed
  safety_door_pin: gpio.15:pu
# Red kills the machine TODO :pu once installed
#reset_pin: gpio.39
# Pause yellow
#  feed_hold_pin:
  cycle_start_pin: gpio.12:pu
#	cycle_start_pin:
# TODO: Big relay for 24v with SET from a button, and RESET from button or failsafe circuit.

start:
  must_home: false
  deactivate_parking: true
  check_limits: true
# dos cables 2m un faston
# medidas tornillo a tornillo 5.7cm center to center
