spsspssps/spscnc/(commit log)

2022-02-06 main project files
    [SDcard.sch, UI.sch, core.sch, espcore.sch, extraCPU.sch, limitIF.sch, probe.sch, psu.sch]
2022-02-09 halfway changes to support additional axis and to extend over i2so
    [SDcard.sch, core.sch, extraCPU.sch, limitIF.sch, probe.sch, psu.sch, psu5v.sch, psu_reverse_polarity.sch]
2022-02-09 added most corrections on the schematic for i2s operation.
    [SDcard.sch, core.sch, extraCPU.sch, limitIF.sch, probe.sch, psu.sch, psu5v.sch, psu_reverse_polarity.sch]
2022-02-10 Improved and validated config file
    [core.sch]
2022-02-10 began routing of the i2so part
    [core.sch, probe.sch, psu.sch, spscnc.sch, stepper.sch, tmc2160_stepper.sch]
2022-02-10 Finished preliminary routing, pending checklist and review
    [core.sch, limitIF.sch, spindle.sch, spscnc.sch, stepper.sch, tmc2160_stepper.sch]
2022-02-12 As ordered 1.0.1
    [SDcard.sch, core.sch, extraCPU.sch, limitIF.sch, probe.sch, psu.sch, psu5v.sch, psu_reverse_polarity.sch]
2022-04-02 Prototype corrections without new PCB
    [core.sch, probe.sch, psu5v.sch, spindle.sch, tmc2160_stepper.sch]
2022-04-05 Reported more defects
    [core.sch, probe.sch]
2022-04-26 Final HW 1.0.1 corrections and straps. All pending corrections will take place as HW 1.1.0 as those require a new PCB
    [spindle.sch]
2022-04-29 Revision 1.1.0 With only critical corrections. Pending some work on the relays as that part could be remade from scratch for flexibility.
    [SDcard.sch, core.sch, extraCPU.sch, limitIF.sch, probe.sch, psu.sch, psu5v.sch, psu_reverse_polarity.sch]
2022-05-07 Added schematic printout
